fjliving/SmartSleeve/images/DSC02135.JPG

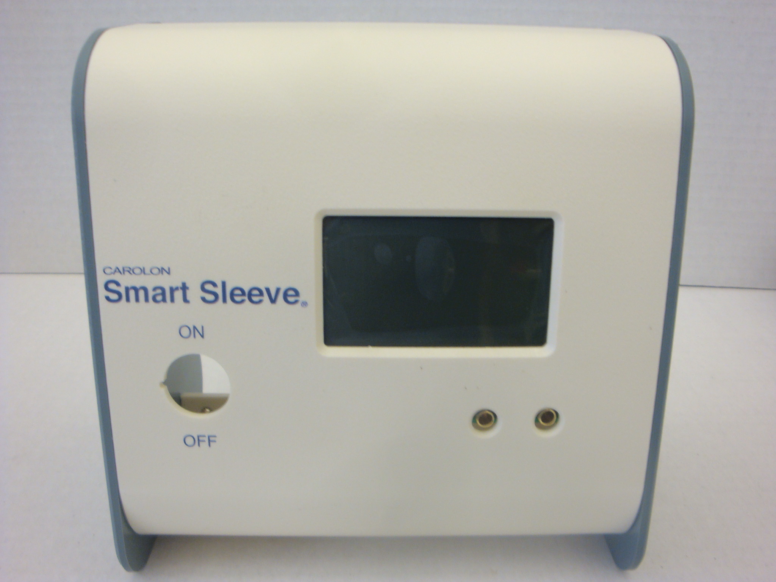
images/DSC02135.JPG
