fjliving/SmartSleeve/images/DSC02167.JPG

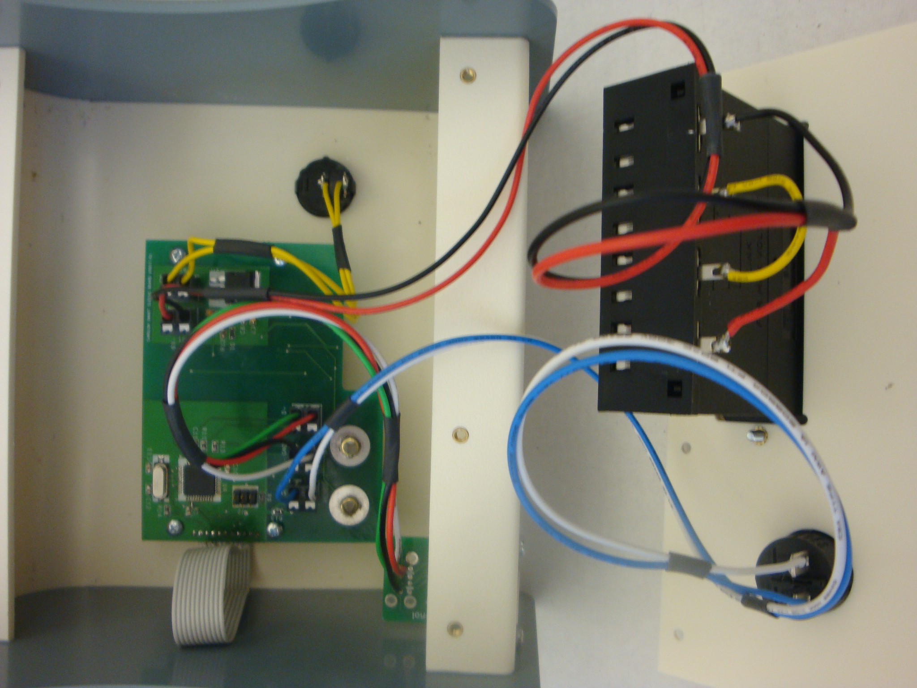
images/DSC02167.JPG
