fjliving/SmartSleeve/cad/6941A002 Smart Reader/GPB527C202Bx.PDF

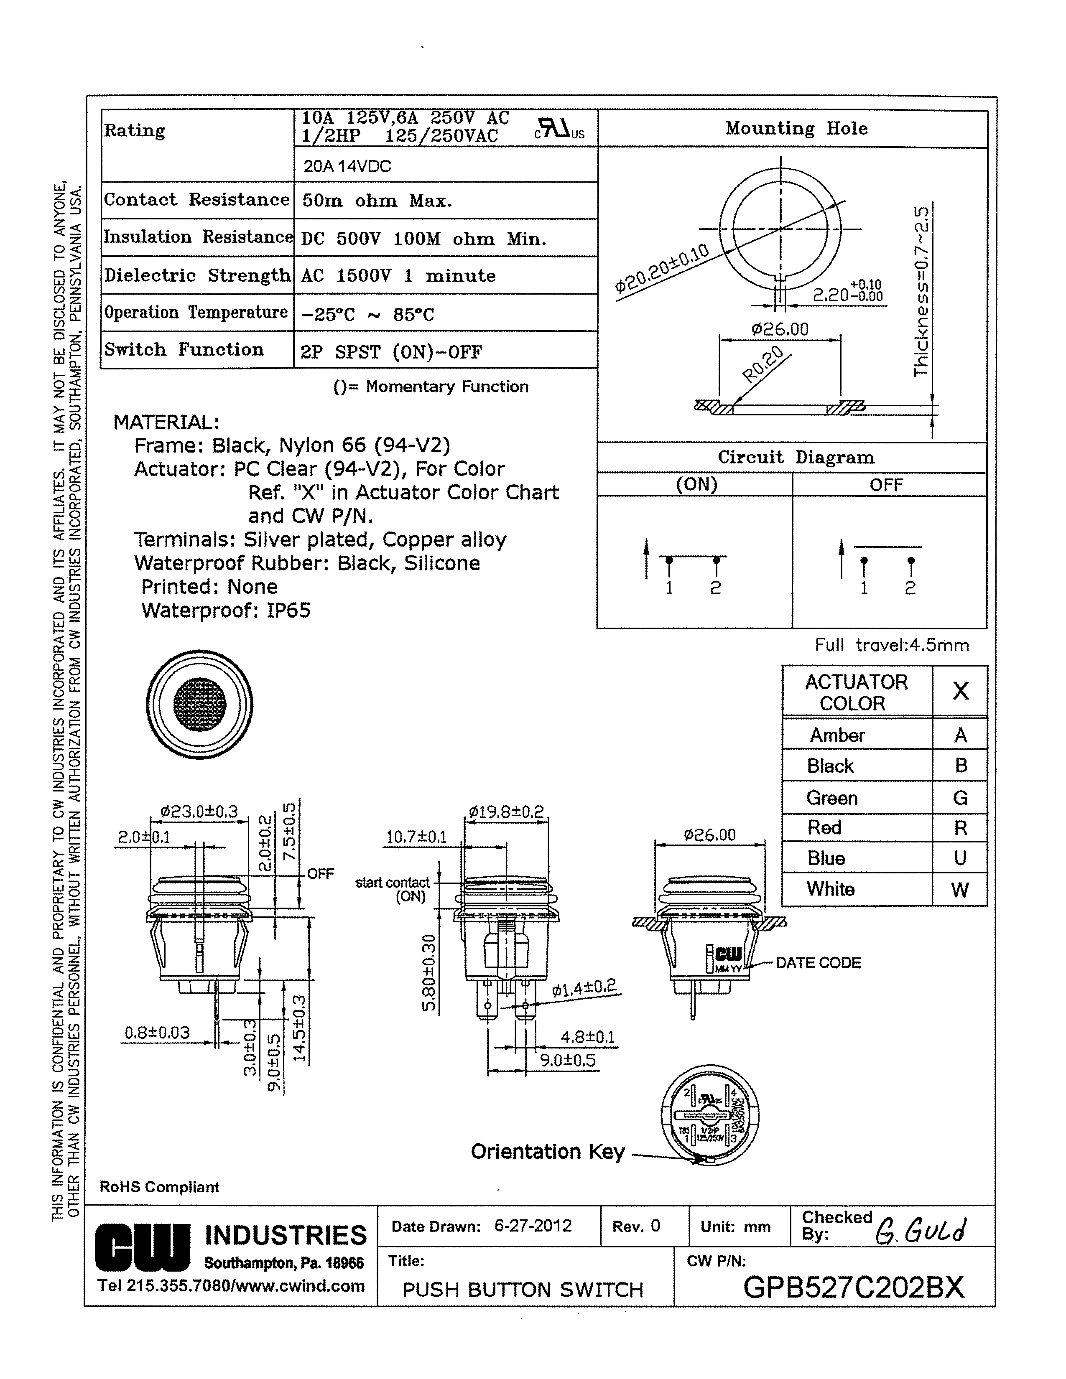
[picture p3: page 1]
