fjliving/SmartSleeve/images/DSC02120.JPG

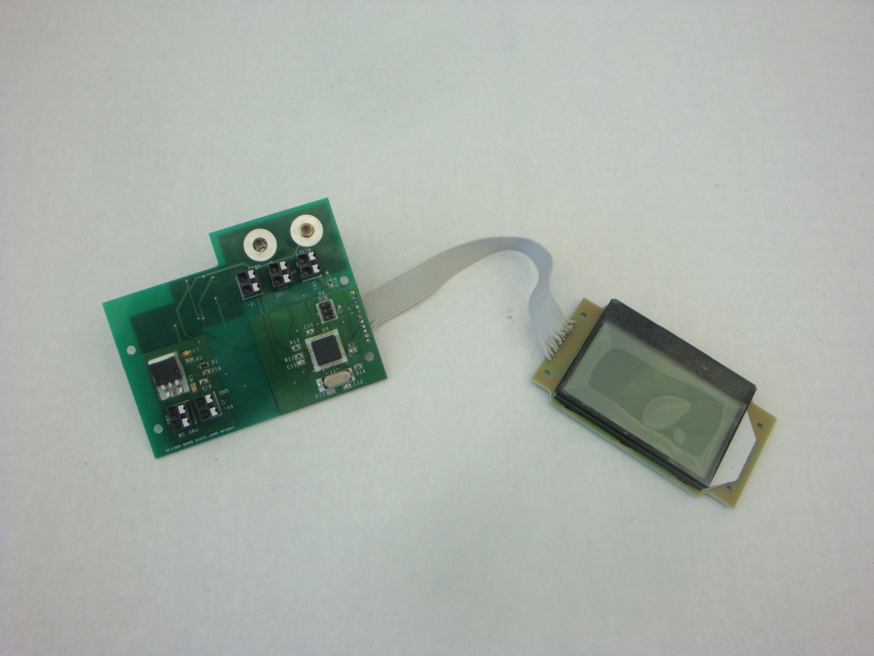
images/DSC02120.JPG
