fjliving/SmartSleeve/images/DSC02123.JPG

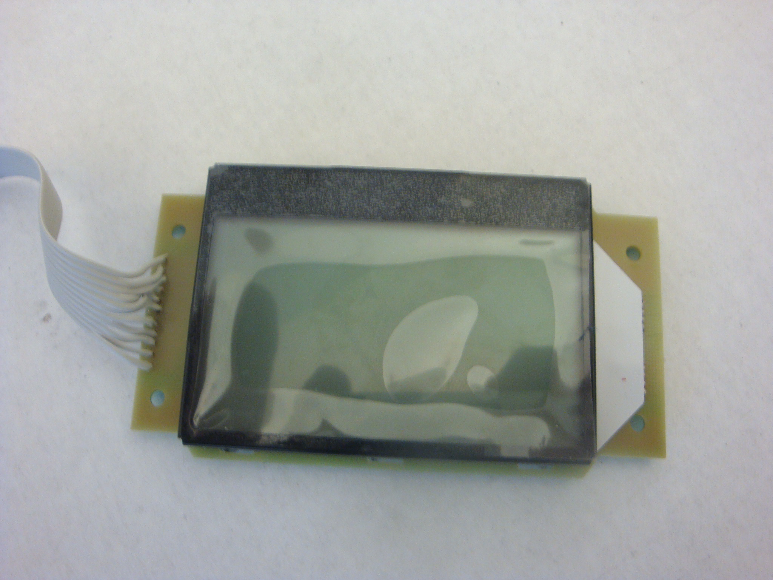
images/DSC02123.JPG
