fjliving/SmartSleeve/images/DSC02127.JPG

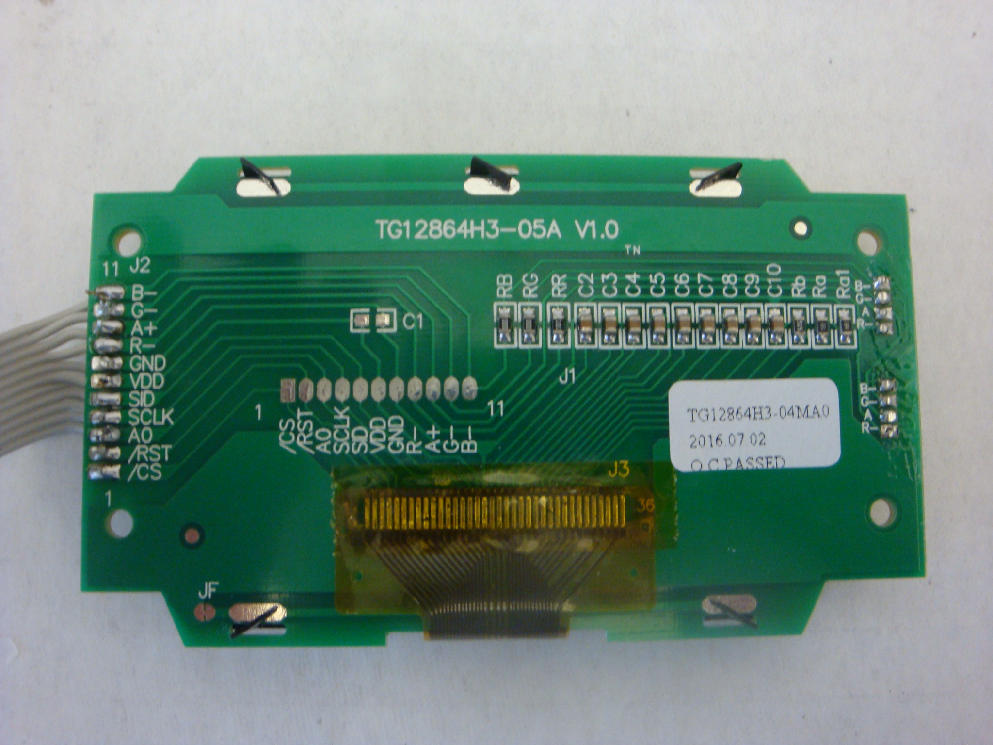
images/DSC02127.JPG
