fjliving/SmartSleeve/images/DSC02134.JPG

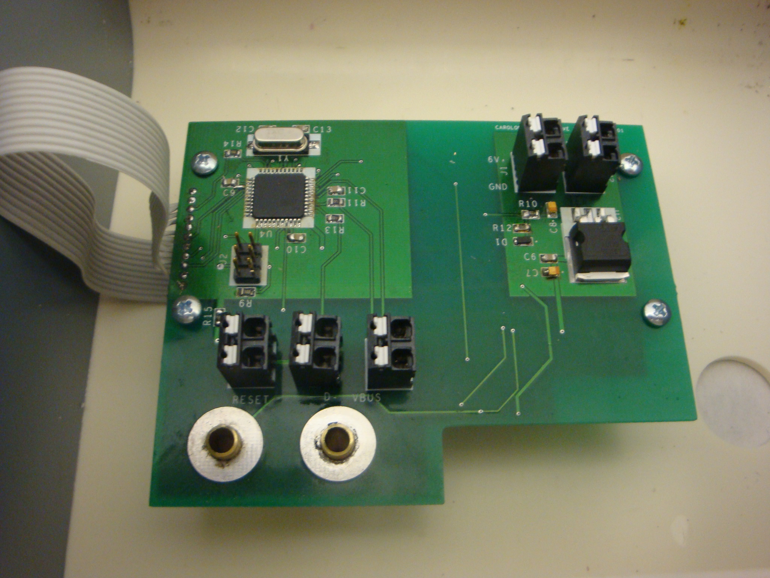
images/DSC02134.JPG
