fjliving/SmartSleeve/images/DSC02145.JPG

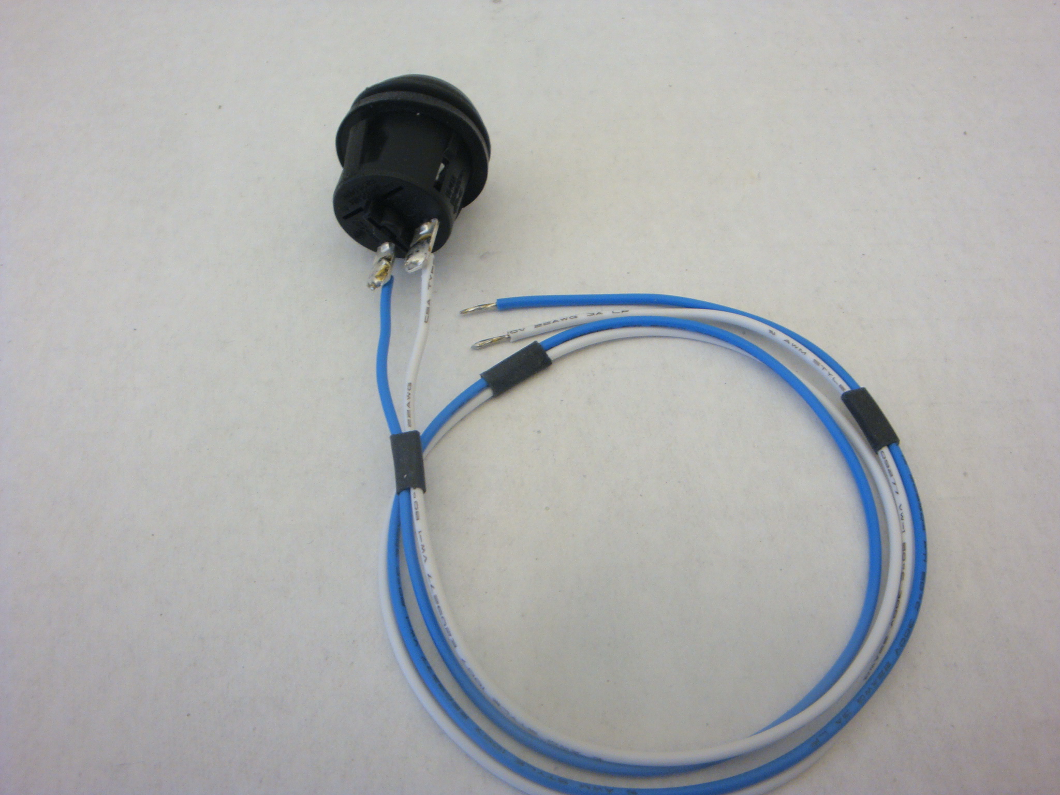
images/DSC02145.JPG
