fjliving/SmartSleeve/images/DSC02146.JPG

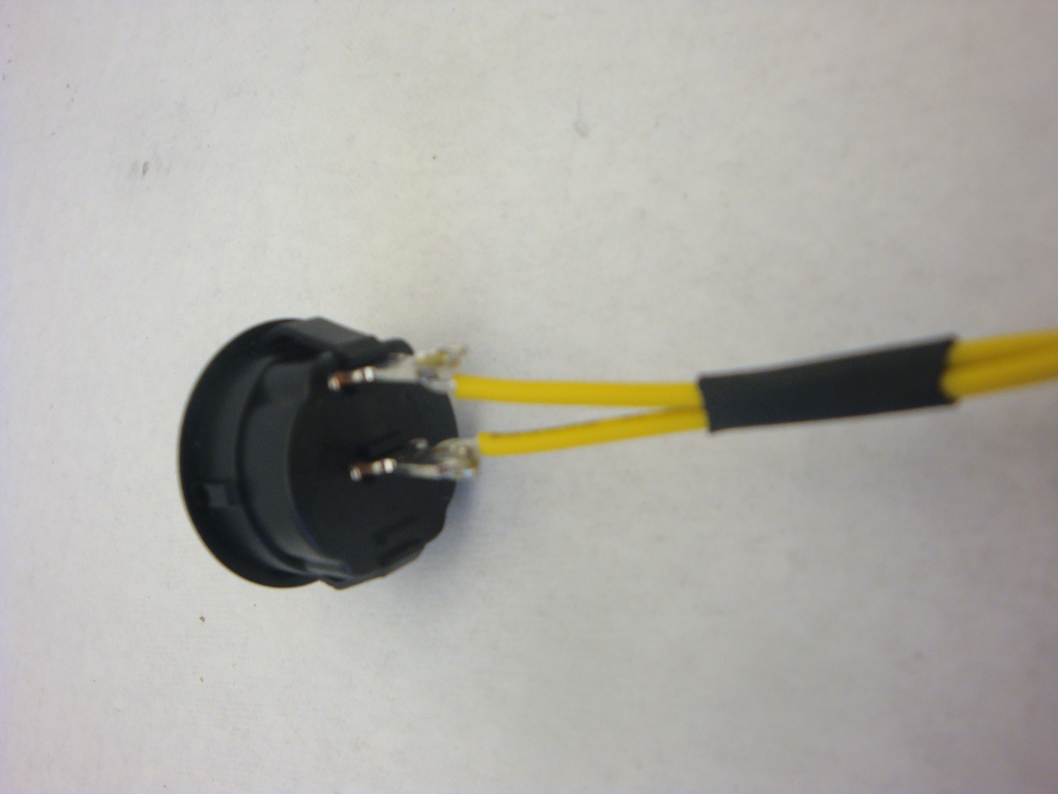
images/DSC02146.JPG
