fjliving/SmartSleeve/images/DSC02156.JPG

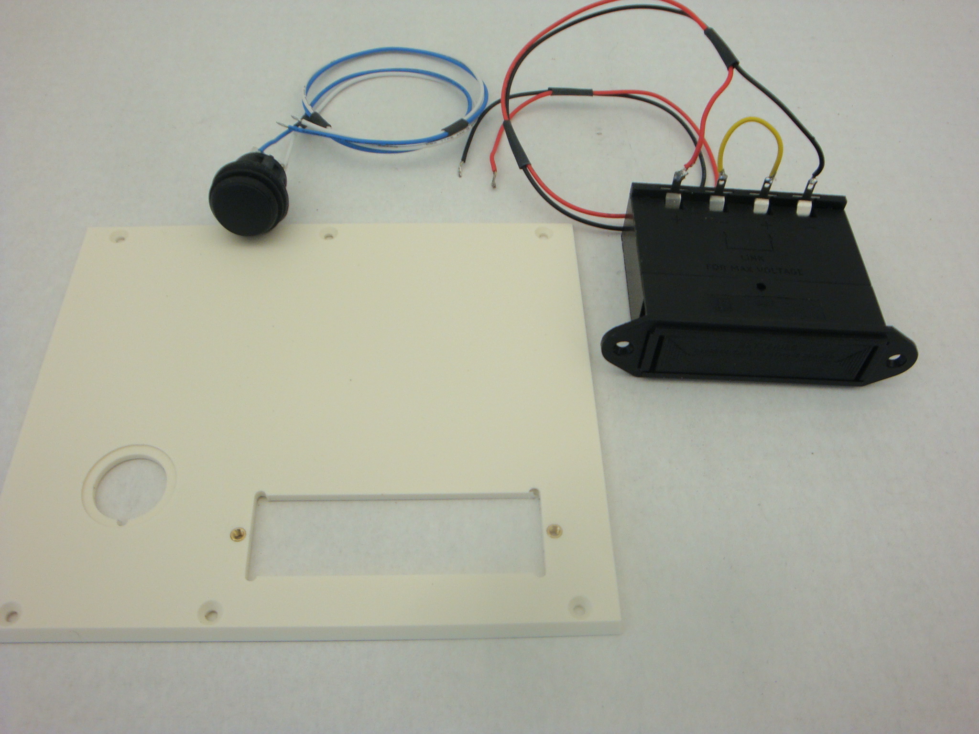
images/DSC02156.JPG
