fjliving/SmartSleeve/images/DSC02157.JPG

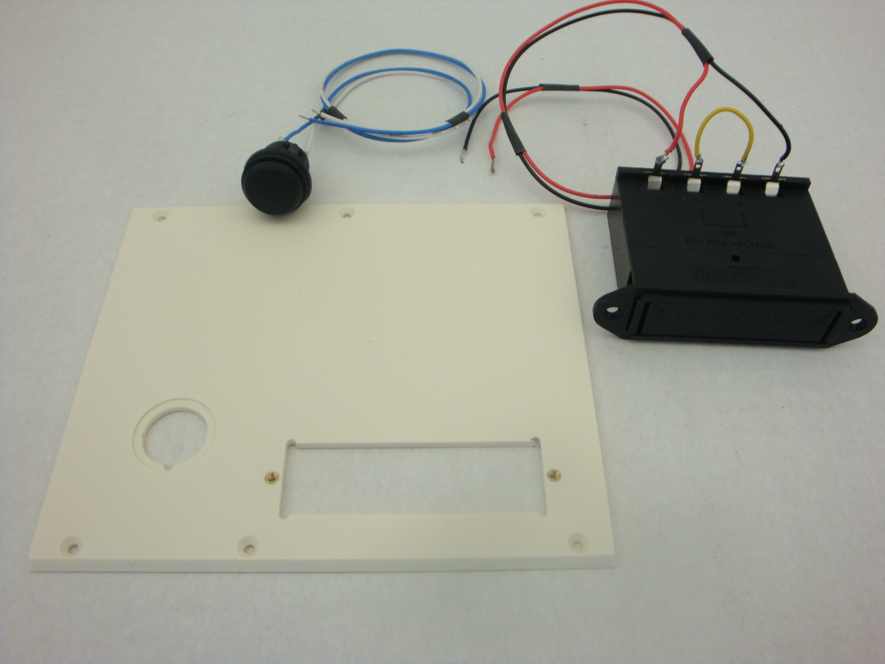
images/DSC02157.JPG
