fjliving/SmartSleeve/images/DSC02166.JPG

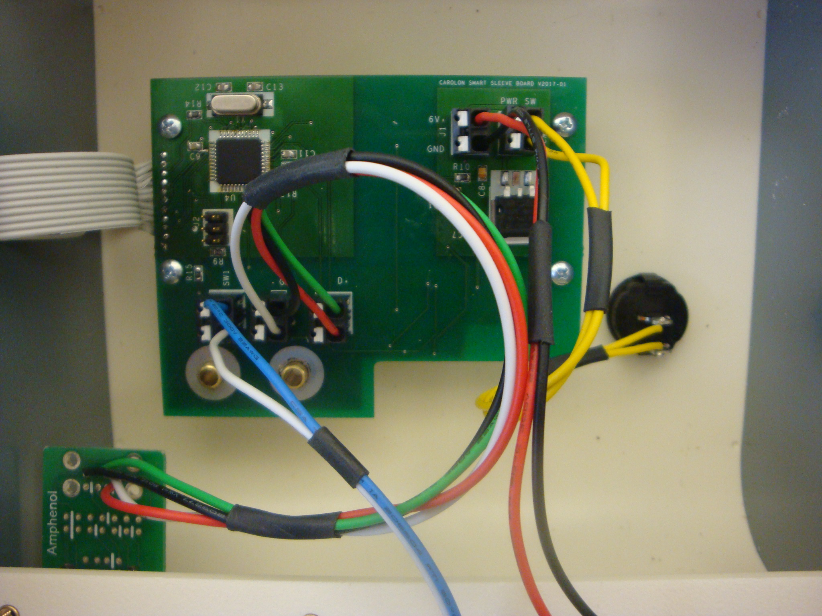
images/DSC02166.JPG
