fjliving/SmartSleeve/images/DSC02176.JPG

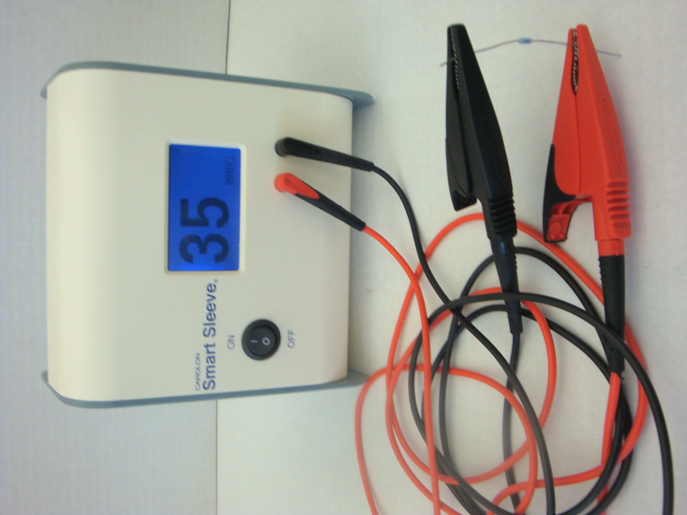
images/DSC02176.JPG
