fjliving/SmartSleeve/images/DSC02177.JPG

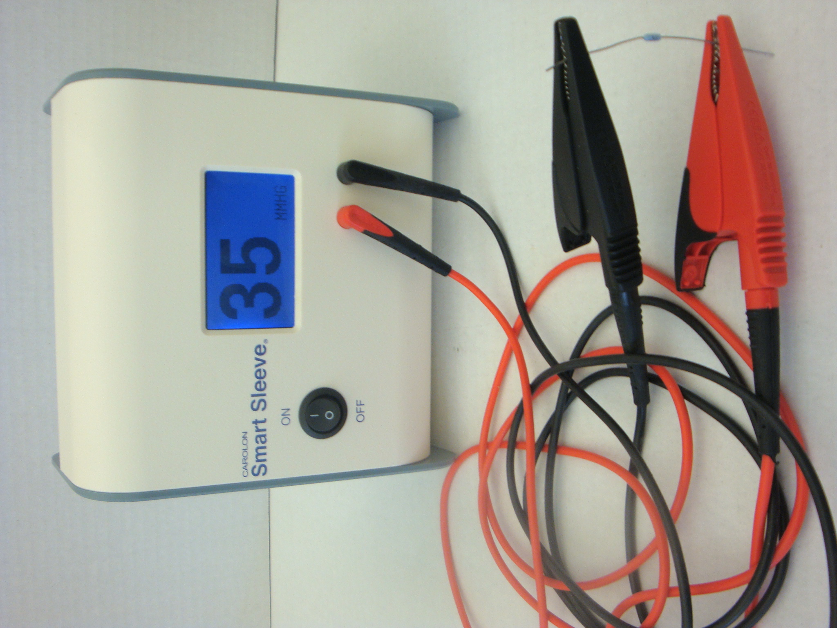
images/DSC02177.JPG
