fjliving/SmartSleeve/images/unnamed (1).jpg

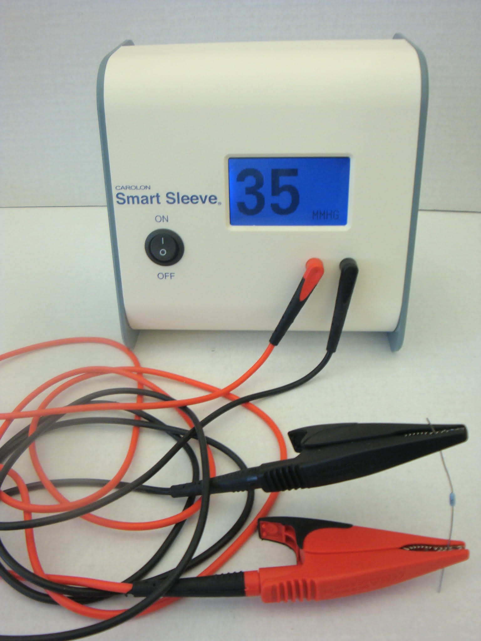
images/unnamed (1).jpg
