fjliving/SmartSleeve/images/unnamed (2).jpg

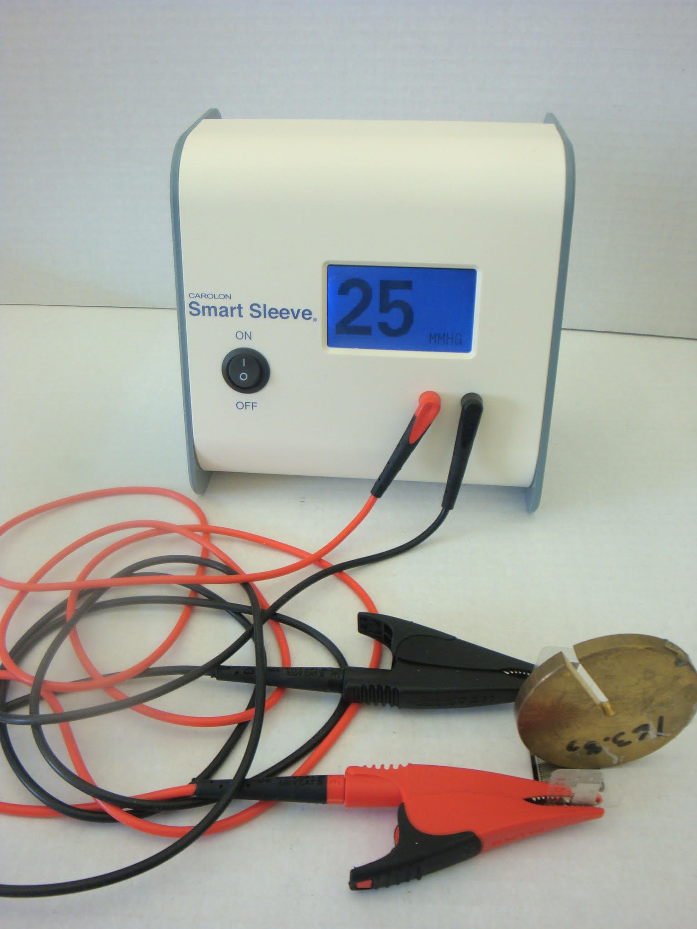
images/unnamed (2).jpg
