fjliving/SmartSleeve/images/unnamed (3).jpg

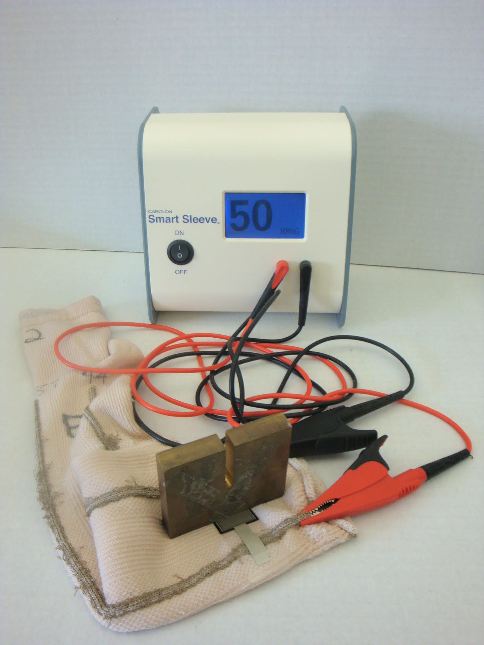
images/unnamed (3).jpg
