fjliving/SmartSleeve/images/unnamed.jpg

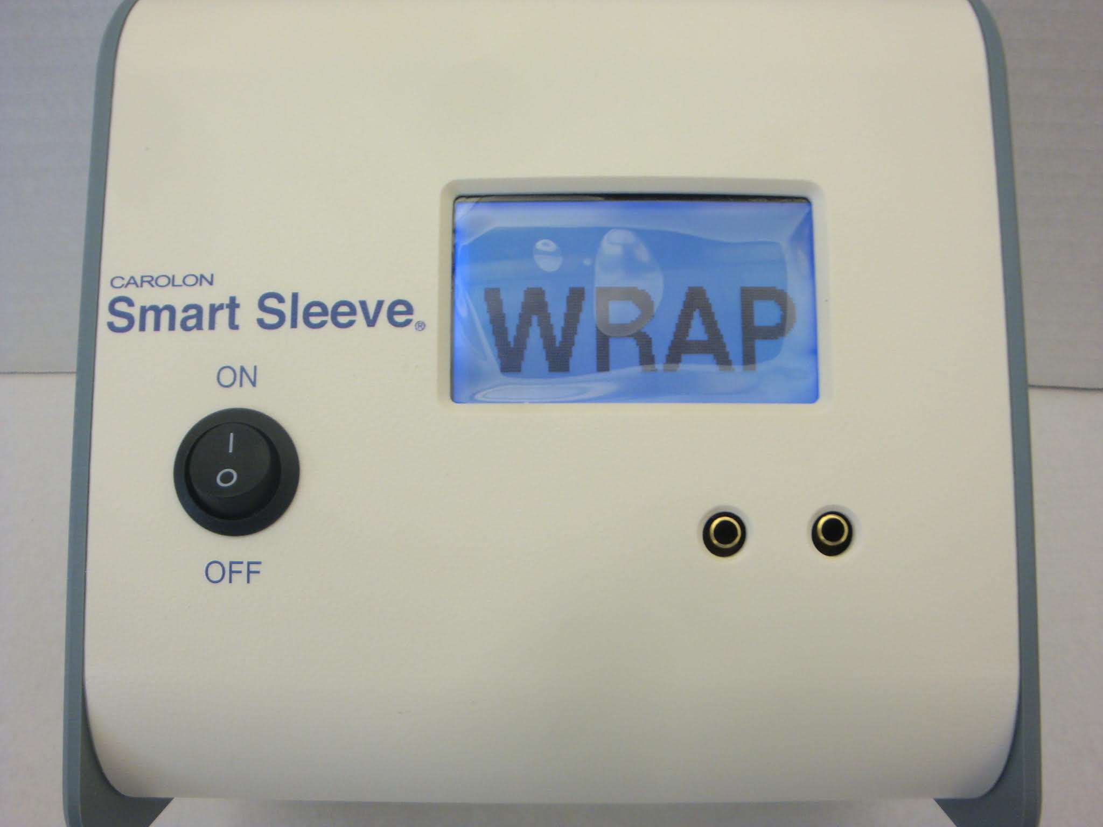
images/unnamed.jpg
