fjliving/SmartSleeve/schematic/SmartSleeveBOM.xlsx

Component | Supplier | Part Number | Item | Footprint | Qnt | Unit Price | Price
ELECTRICAL
U5 | DigiKey | 3M9337-ND | Header 2mm (40 pins) | N/A | 1 | 2.3 | 2.3
J8,J9 | DigiKey | 36-575-8-ND | JACK NON-INSULATED .350" | 129-0701-202 | 2 | 0.99 | 1.98
U5 | AdaFruit | 250 | Graphic ST7565 Positive LCD (https://www.adafruit.com/products/250) | ST7565 | 1 | 16.6 | 16.6
J1 | DigiKey | 708-1399-ND | HOLDER BATTERY 4 CELL AA | N/A | 1 | 20.72 | 20.72
SW2 | DigiKey | EG4777-ND | Rocker Switch SPST | N/A | 1 | 0.93 | 0.93
J10, J11 | DigiKey | MUSBAA11M0-ND | USB Connector | N/A | 1 | 17.35 | 17.35
J1, SW2, J10, J11, SW1 | DigiKey | 277-11636-1-ND | 2 Position Wire to Board Terminal Block | DIP500P550X533-4N | 5 | 1.86 | 9.3
R3,R8 | DigiKey | A110542CT-ND (http://www.digikey.com/product-detail/en/te-connectivity-passive-product/1-2176092-7/A110542CT-ND/4034897) | RES SMD 976 OHM 0.1% 1/4W 0805 | RESC2013X140N | 2 | 0.61 | 1.22
R4,R5,R7 | DigiKey | YAG1988CT-ND (http://www.digikey.com/product-detail/en/yageo/RT0805BRD078K2L/YAG1988CT-ND/5139436) | RES SMD 8.2K OHM 0.1% 1/8W 0805 | RESC2013X140N | 3 | 0.35 | 1.05
R1 | DigiKey | P100KDACT-ND (http://www.digikey.com/product-detail/en/panasonic-electronic-components/ERA-6AEB104V/P100KDACT-ND/1465995) | RES SMD 100K OHM 0.1% 1/8W 0805 | RESC2013X140N | 1 | 0.39 | 0.39
R6 | DigiKey | YAG1766CT-ND (http://www.digikey.com/product-detail/en/yageo/RT0805BRD07113KL/YAG1766CT-ND/5139214) | RES SMD 113K OHM 0.1% 1/8W 0805 | RESC2013X140N | 1 | 0.35 | 0.35
R12 | DigiKey | 311-7.15KCRCT-ND (http://www.digikey.com/product-detail/en/yageo/RC0805FR-077K15L/311-7.15KCRCT-ND/731057) | RES SMD 7.15K OHM 1% 1/8W 0805 | RESC2013X140N | 1 | 0.1 | 0.1
U2 | DigiKey | 497-1224-1-ND (http://www.digikey.com/product-detail/en/stmicroelectronics/LD1086D2T33TR/497-1224-1-ND/586224) | LD1086 IC REG LDO 3.3V 1.5A D2PAK | TO254P1394X457-4N | 1 | 0.96 | 0.96
R2,R14 | DigiKey | 311-100CRCT-ND (http://www.digikey.com/product-detail/en/yageo/RC0805FR-07100RL/311-100CRCT-ND/730490) | RES SMD 100 OHM 1% 1/8W 0805 | RESC2013X140N | 2 | 0.1 | 0.2
R9,R10 | DigiKey | 311-10KARCT-ND (http://www.digikey.com/product-detail/en/yageo/RC0805JR-0710KL/311-10KARCT-ND/731188) | RES SMD 10K OHM 5% 1/8W 0805 | RESC2013X140N | 2 | 0.1 | 0.2
R11,R13 | DigiKey | RMCF0805JT22R0CT-ND (http://www.digikey.com/product-detail/en/stackpole-electronics-inc/RMCF0805JT22R0/RMCF0805JT22R0CT-ND/1942533) | RES SMD 22 OHM 5% 1/8W 0805 | RESC2013X140N | 2 | 0.1 | 0.2
R15 | DigiKey | 311-0.0ARCT-ND (http://www.digikey.com/product-detail/en/yageo/RC0805JR-070RL/311-0.0ARCT-ND/731163) | RES SMD 0.0 OHM JUMPER 1/8W 0805 | RESC2013X140N | 1 | 0.1 | 0.1
U1 | DigiKey | 296-15953-1-ND (http://www.digikey.com/product-detail/en/texas-instruments/INA327EA-250/296-15953-1-ND/606779) | IC OPAMP INSTR 1KHZ RRO 10VSSOP | SOP50P440X140-10N | 1 | 6.21 | 6.21
D1 | DigiKey | 641-1056-1-ND (http://www.digikey.com/product-detail/en/comchip-technology/CZRF52C3V3/641-1056-1-ND/1121178) | DIODE ZENER 3.3V 200MW 1005 | DIOC2512X140N | 1 | 0.54 | 0.54
C1,C7,C8 | DigiKey | 478-3281-1-ND (http://www.digikey.com/product-detail/en/avx-corporation/TAJP106M010RNJ/478-3281-1-ND/930073) | CAP TANT 10UF 10V 20% 0805 | CAPCP2013X140N | 3 | 1.01 | 3.03
C2,C4,C6,C9,C10,C11 | DigiKey | 478-1395-1-ND (http://www.digikey.com/product-detail/en/avx-corporation/08055C104KAT2A/478-1395-1-ND/564427) | CAP CER 0.1UF 50V X7R 0805 | CAPC2013X140N | 6 | 0.1 | 0.6
C3 | DigiKey | 311-1365-1-ND (http://www.digikey.com/product-detail/en/yageo/CC0805KKX7R7BB105/311-1365-1-ND/2103149) | CAP CER 1UF 16V X7R 0805 | CAPC2013X140N | 1 | 0.1 | 0.1
C12,C13 | DigiKey | 276-1107-1-ND (http://www.digikey.com/product-detail/en/samsung-electro-mechanics-america-inc/CL21C180JBANNNC/1276-1107-1-ND/3889193) | CAP CER 18PF 50V NP0 0805 | CAPC2013X140N | 2 | 0.1 | 0.2
C5 | DigiKey | 399-1147-1-ND (http://www.digikey.com/product-detail/en/kemet/C0805C102K5RACTU/399-1147-1-ND/411422) | CAP CER 1000PF 50V X7R 0805 | CAPC2013X140N | 1 | 0.1 | 0.1
U4 | DigiKey | ATMEGA32U4-AURCT-ND (http://www.digikey.com/product-detail/en/microchip-technology/ATMEGA32U4-AUR/ATMEGA32U4-AURCT-ND/3440960) | IC MCU 8BIT 32KB FLASH 44TQFP | QFP80P1200X1200X120-45N | 1 | 4.2 | 4.2
Y1 | DigiKey | 887-1274-1-ND (http://www.digikey.com/product-detail/en/txc-corporation/9C-16.000MEEJ-T/887-1274-1-ND/2207856) | CRYSTAL 16.0000MHZ 18PF SMD | CRYSTAL1190X300N | 1 | 0.59 | 0.59
J2 | DigiKey | 609-3234-ND | CONN HEADER 6POS .100 STR 15AU | DIP254P254X533-6N | 1 | 0.31 | 0.31
SW1 | DigiKey | CW153-ND | SWITCH PUSH SPST-NO 10A 125V | N/A | 1 | 2.41 | 2.41
J4,J5,J6,J7 | N/A | N/A | MNT HOLES | HOLE125 | 1 | 0 | 0
U6 | DigiKey | LT1790BCS6-3#TRMPBFCT-ND (http://www.digikey.com/product-detail/en/linear-technology/LT1790BCS6-3-TRMPBF/LT1790BCS6-3-TRMPBFCT-ND/889008) | IC VREF SERIES 3V SOT23-6 | SOT95P280X112-6N | 1 | 3.18 | 3.18
MECHANICAL
 | McMasterCarr | 90295A340 | Washer Number 4 Screw Size, 0.112" ID, 0.206" OD (100 QTY) | 4 per enclosure | 1 | 5.17 | 5.17
 | McMasterCarr | 90272A077 | 2-56 Thread Size, 1/4" Long (100 QTY) | 2 per enclosure | 1 | 2.64 | 2.64
 | McMasterCarr | 90272A108 | 4-40 Thread Size, 3/8" Long (100 QTY) | 8 per enclosure | 1 | 1.6 | 1.6
 | Toolless |  | Production Enclosure (25x $50.42, 50x 42.01, 100x $35.01) |  | 1 | 50.42 | 50.42
 | Toolless |  | Digital Printing (25x $9.96, 50x $5.70, 100x $3.80) |  | 1 | 9.96 | 9.96
 |  |  | TOTAL |  | 54 |  | 165.21
 | Obmitted from Design FJL 03/07/2017
