fjliving/SmartSleeve/cad/6941A001 Smart Reader 2016-12-15/6941 500 Smart Reader.SLDASM

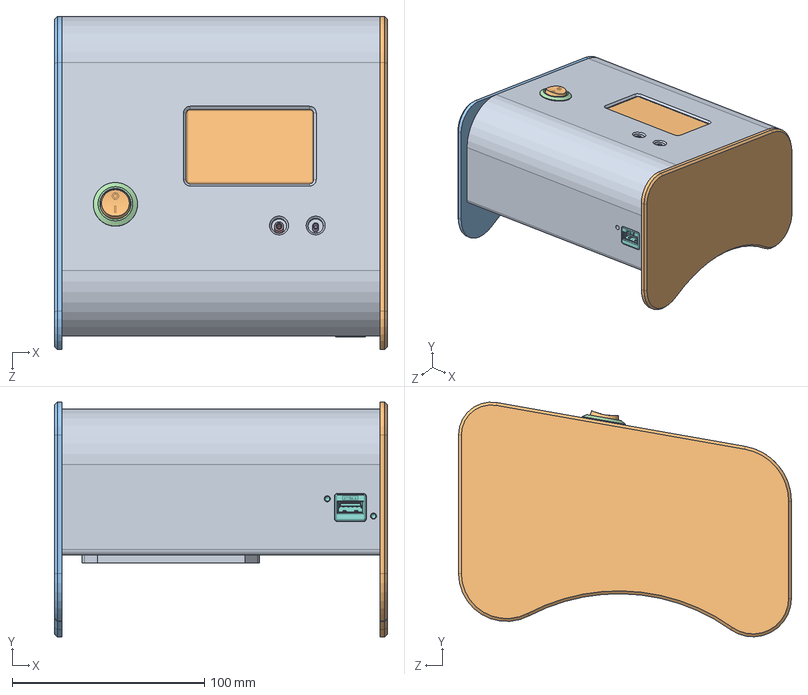
[picture p19: CAD file, 2017-01-30]
cad/6941A001 Smart Reader 2016-12-15/6941 500 Smart Reader.SLDASM
173.1 x 121.9 x 173.0 mm
6941 AA Wrap
6941 AB End Cap
6941 AD Mtg Bar x 2
6941 AE Access Panel
CLPM50H120 x 4
INS440135 x 8
INSM25135 x 4
pcb
lcd_pcb
951140-8622-AR
90295A040_NYLON FLAT WASHER x 4
277-11614-1-ND x 4
MUSBAA11M0
bx0027
RR5-ROCKER I-O
RR5-4.8 TAB Small Hole x 2
RR5 BODY
