fjliving/SmartSleeve/cad/solidworks_2016_org/PCB smartreader_v3.SLDASM

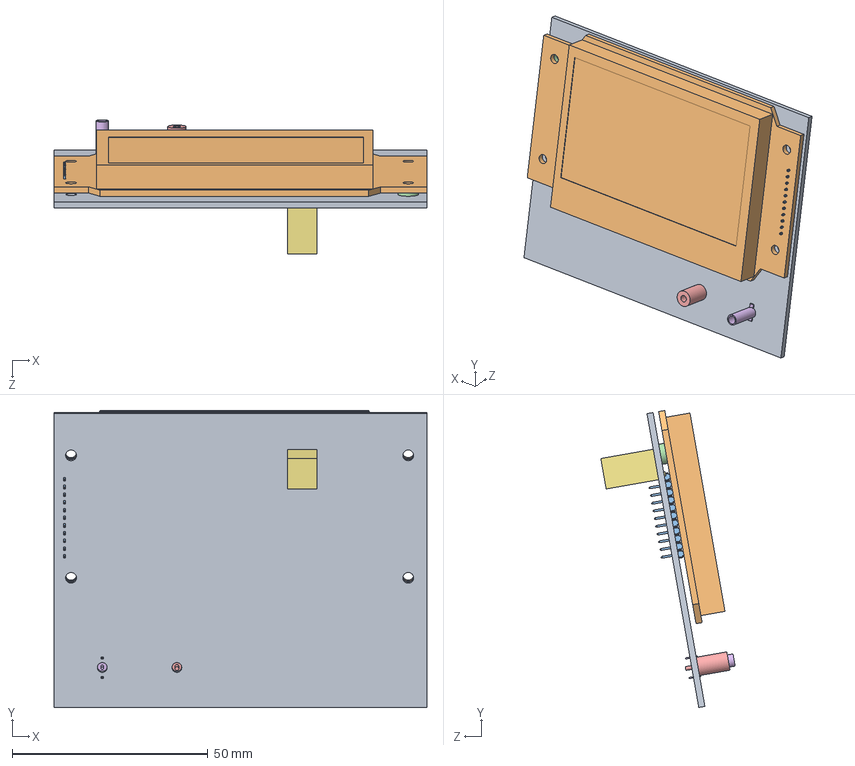
[picture p20: CAD file, 2017-01-30]
cad/solidworks_2016_org/PCB smartreader_v3.SLDASM
95.2 x 75.8 x 34.3 mm
pcb
lcd_pcb
951140-8622-AR
90295A040_NYLON FLAT WASHER
277-11614-1-ND
