fjliving/SmartSleeve/cad/6941A001 Smart Reader 2016-12-15/PCB smartreader_v3.SLDASM

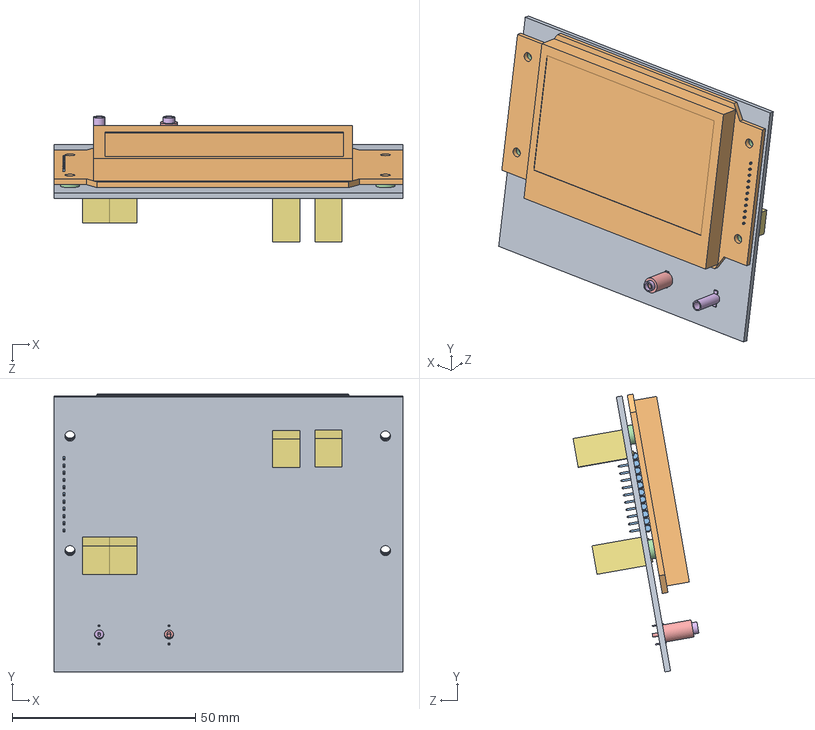
[picture p21: CAD file, 2017-01-30]
cad/6941A001 Smart Reader 2016-12-15/PCB smartreader_v3.SLDASM
95.2 x 75.8 x 34.3 mm
pcb
lcd_pcb
951140-8622-AR
90295A040_NYLON FLAT WASHER x 4
277-11614-1-ND x 4
