fjliving/SmartSleeve/cad/solidworks_2016_org/RR5-4.8 Rocker Switch.SLDASM

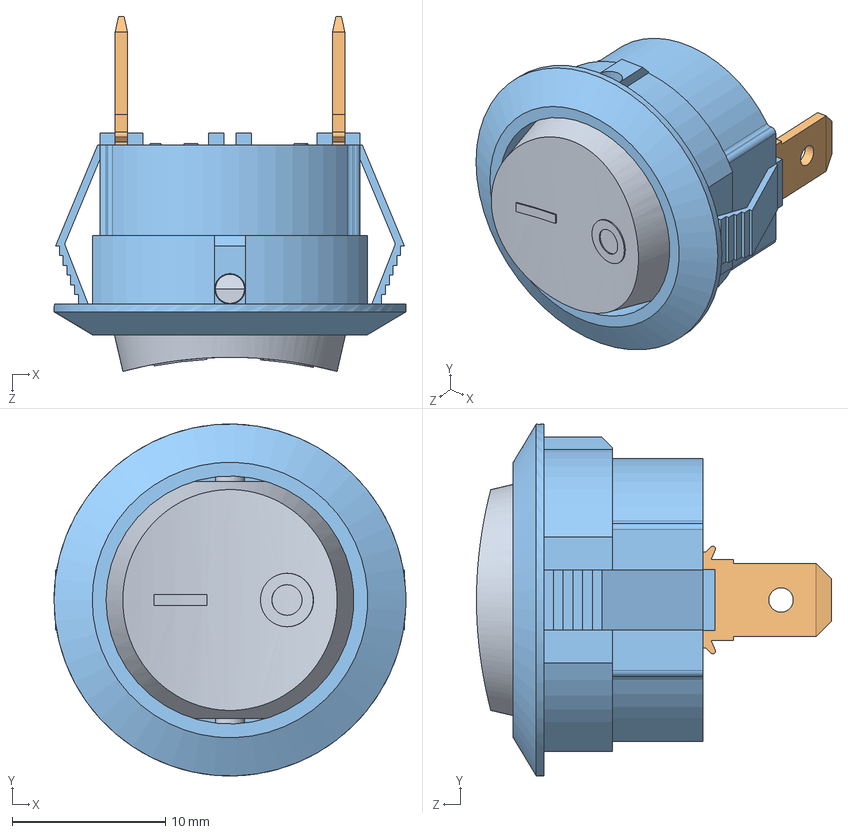
[picture p22: CAD file, 2017-01-10]
cad/solidworks_2016_org/RR5-4.8 Rocker Switch.SLDASM
23.0 x 23.0 x 23.2 mm
RR5-ROCKER I-O
RR5-4.8 TAB Small Hole x 2
RR5 BODY
