fjliving/SmartSleeve/cad/solidworks_2016_org/smartreader_v3.SLDASM

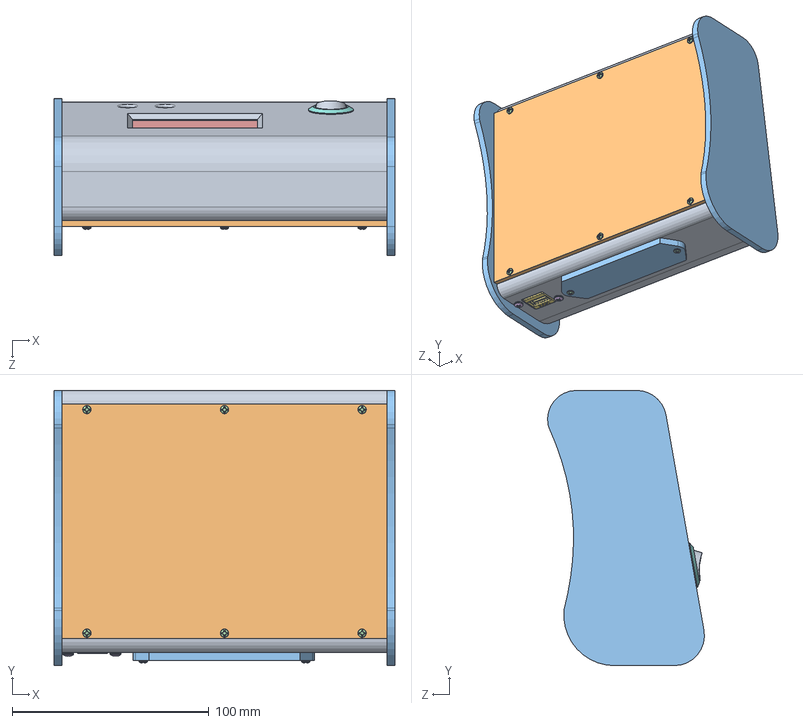
[picture p23: CAD file, 2016-12-14]
cad/solidworks_2016_org/smartreader_v3.SLDASM
173.1 x 139.7 x 79.6 mm
case_front_flange
case_back_flange
case_stand x 2
pcb
lcd_pcb
951140-8622-AR
90295A040_NYLON FLAT WASHER x 4
277-11614-1-ND x 4
bx0027
90272A077_ZINC-PLTD STL PAN HEAD PHILLIPS MACHINE SCREW x 12
92394A111_18-8SS PRESS-FIT EXPANSION INSERT FOR PLASTIC x 8
90272A108_ZINC-PLTD STL PAN HEAD PHILLIPS MACHINE SCREW x 2
MUSBAA11M0
RR5 BODY
RR5-ROCKER I-O
RR5-4.8 TAB Small Hole x 2
