fjliving/SmartSleeve/cad/solidworks_2016_org/RR51xDxx21.SLDASM

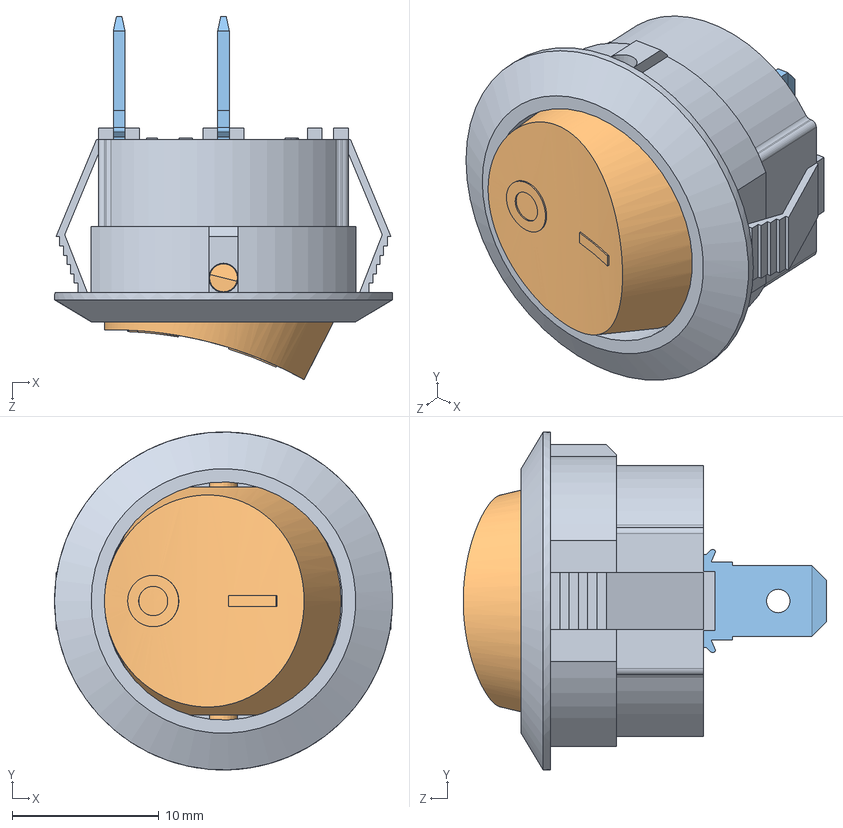
[picture p24: CAD file, 2016-12-14]
cad/solidworks_2016_org/RR51xDxx21.SLDASM
23.0 x 23.0 x 24.7 mm
RR5 BODY
RR5-ROCKER I-O
RR5-4.8 TAB Small Hole x 2
