fjliving/SmartSleeve/cad/solidworks_2016_org/smartreader_lcd_v3.SLDASM

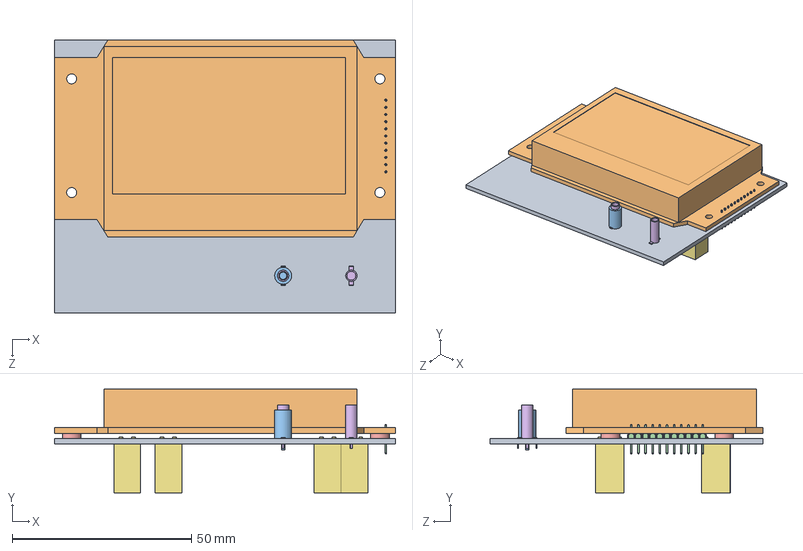
[picture p25: CAD file, 2016-12-14]
cad/solidworks_2016_org/smartreader_lcd_v3.SLDASM
95.2 x 29.0 x 76.2 mm
pcb
lcd_pcb
951140-8622-AR
90295A040_NYLON FLAT WASHER x 4
277-11614-1-ND x 4
