fjliving/SmartSleeve/cad/solidworks_2016_org/M-MUSB-AA11-XX-REVG1.SLDASM

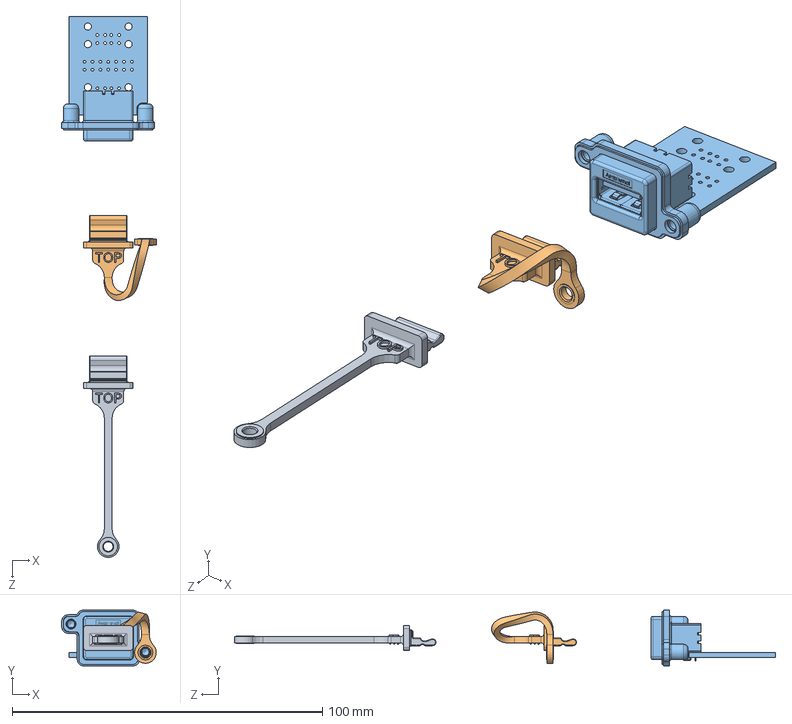
[picture p26: CAD file, 2016-12-14]
cad/solidworks_2016_org/M-MUSB-AA11-XX-REVG1.SLDASM
30.5 x 18.0 x 174.5 mm
MUSB-2A111-0X4 STRAIGHT
MUSB-2A111-0X4-ASSY
MUSB-AA11-35
