fjliving/SmartSleeve/cad/encaps/6941 AB End Cap.DXF

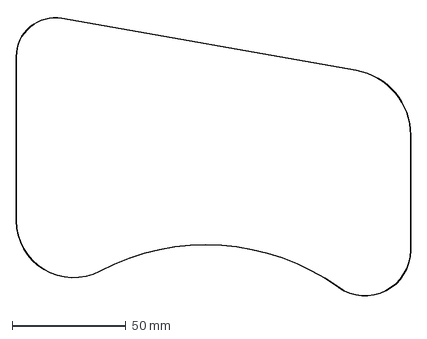
[picture p27: CAD file, 2017-01-10]
cad/encaps/6941 AB End Cap.DXF
173.0 x 123.8 mm
