fjliving/SmartSleeve/cad/6941A001 Smart Reader 2016-12-15/6941 AB End Cap.SLDPRT

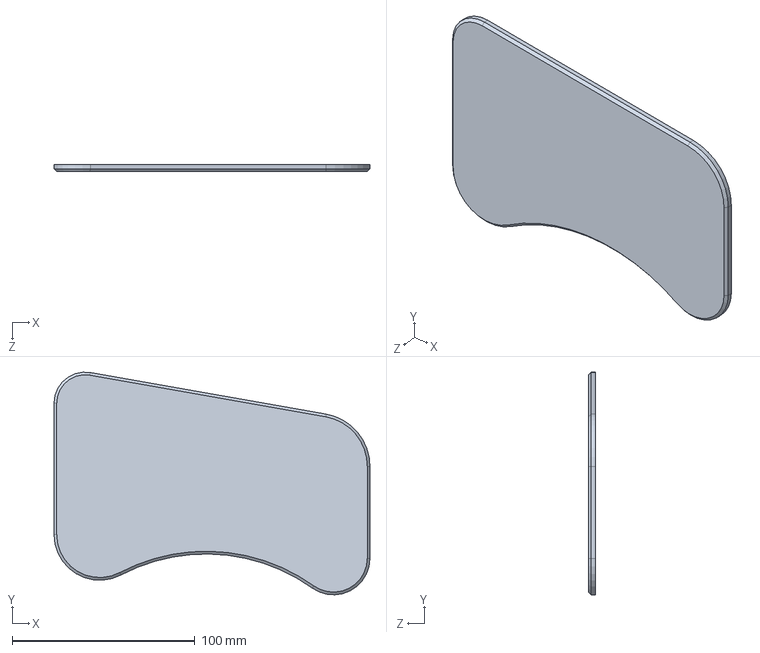
[picture p28: CAD file, 2017-01-30]
cad/6941A001 Smart Reader 2016-12-15/6941 AB End Cap.SLDPRT
173.0 x 121.9 x 4.00 mm
