fjliving/SmartSleeve/cad/solidworks_2016_org/lcd_pcb.SLDPRT

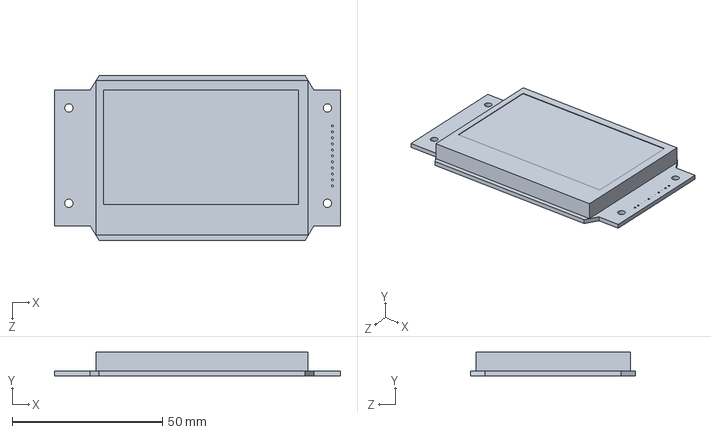
[picture p29: CAD file, 2017-01-30]
cad/solidworks_2016_org/lcd_pcb.SLDPRT
95.2 x 7.84 x 55.0 mm
