fjliving/SmartSleeve/cad/solidworks_2016_org/INSM25135.SLDPRT

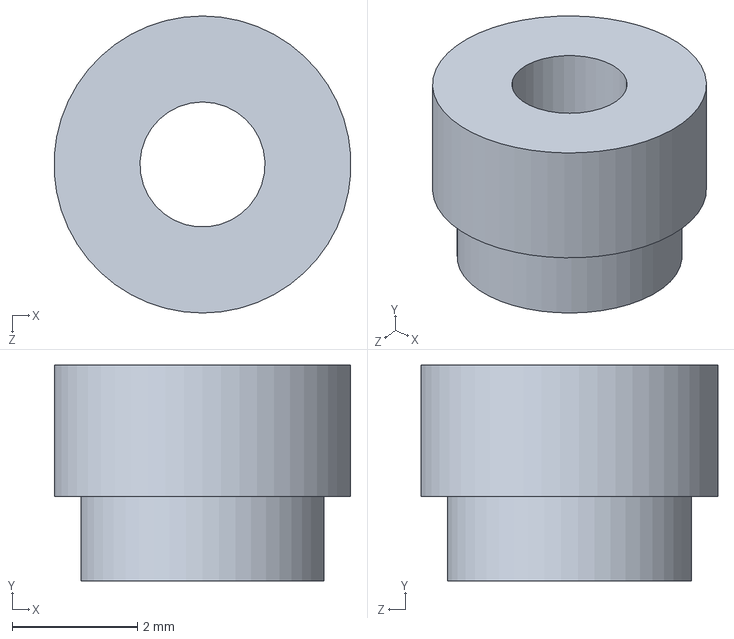
[picture p30: CAD file, 2017-01-10]
cad/solidworks_2016_org/INSM25135.SLDPRT
4.74 x 3.45 x 4.75 mm
