fjliving/SmartSleeve/cad/6941A001 Smart Reader 2016-12-15/CLPM50H120.SLDPRT

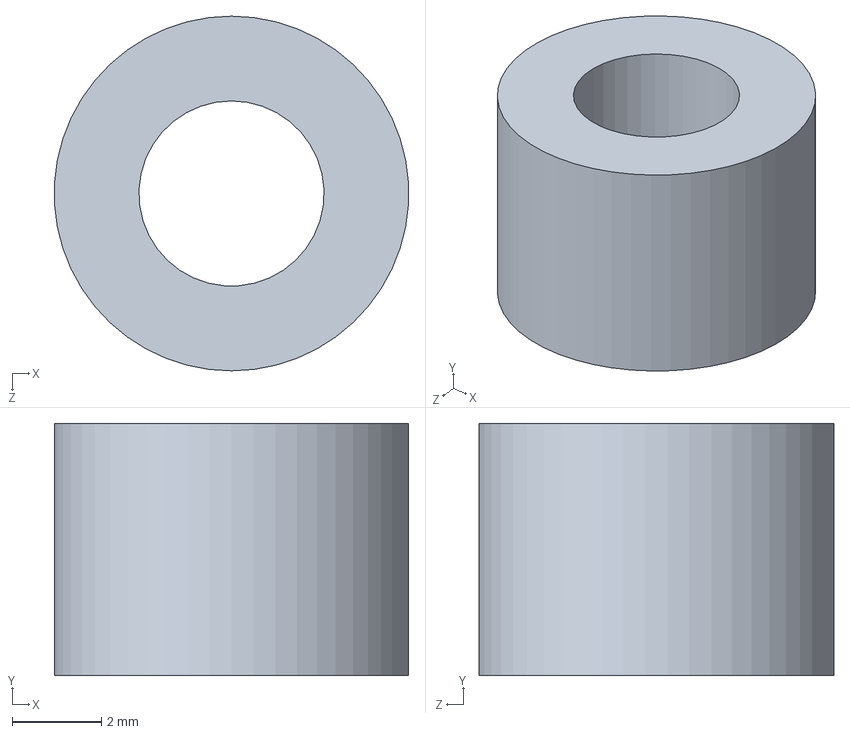
[picture p31: CAD file, 2017-01-30]
cad/6941A001 Smart Reader 2016-12-15/CLPM50H120.SLDPRT
7.93 x 5.65 x 7.95 mm
