fjliving/SmartSleeve/cad/solidworks_2016_org/case_stand.SLDPRT

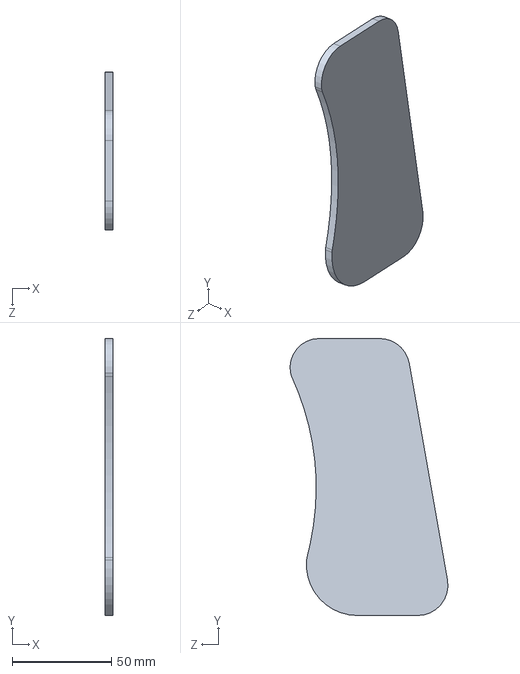
[picture p32: CAD file, 2016-12-14]
cad/solidworks_2016_org/case_stand.SLDPRT
4.00 x 139.7 x 79.6 mm
