fjliving/SmartSleeve/cad/6941A001 Smart Reader 2016-12-15/RR5 BODY.sldprt

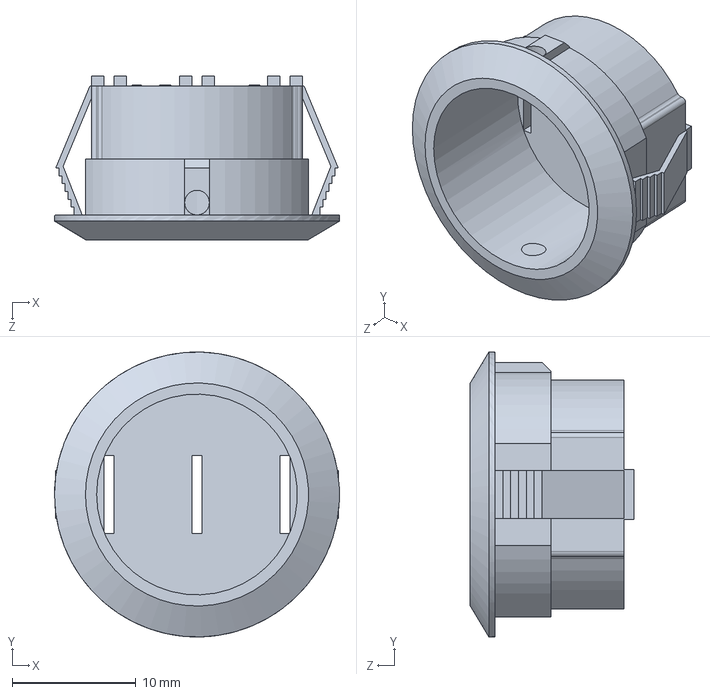
[picture p33: CAD file, 2017-01-10]
cad/6941A001 Smart Reader 2016-12-15/RR5 BODY.sldprt
23.0 x 23.0 x 13.2 mm
