fjliving/SmartSleeve/cad/solidworks_2016_org/case_front_flange.SLDPRT

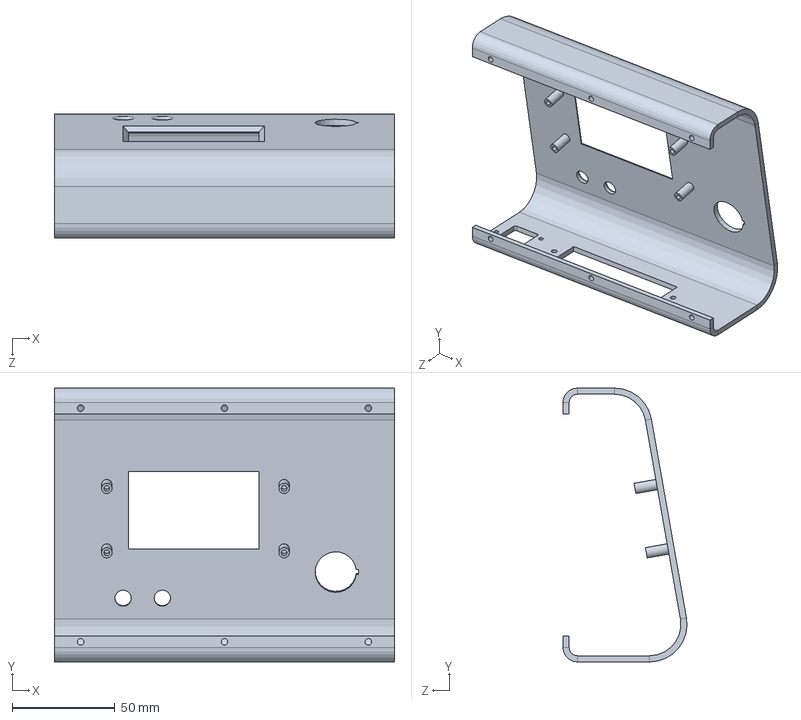
[picture p34: CAD file, 2016-12-14]
cad/solidworks_2016_org/case_front_flange.SLDPRT
165.1 x 133.0 x 60.2 mm
