fjliving/SmartSleeve/cad/6941A001 Smart Reader 2016-12-15/6941 AB End Cap_ORG.SLDPRT

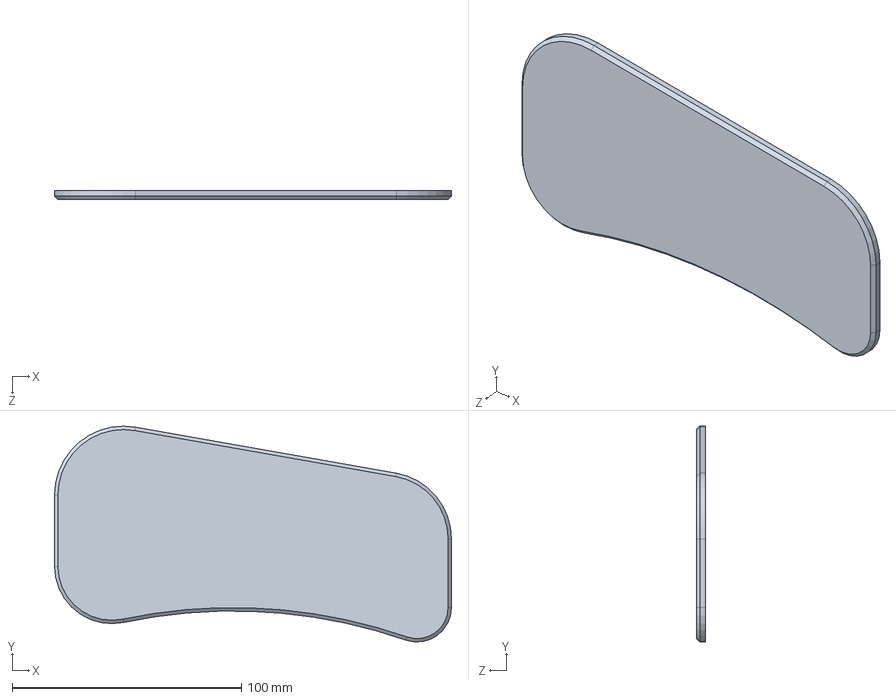
[picture p35: CAD file, 2017-01-10]
cad/6941A001 Smart Reader 2016-12-15/6941 AB End Cap_ORG.SLDPRT
173.0 x 94.0 x 4.00 mm
