fjliving/SmartSleeve/cad/solidworks_2016_org/case_back_flange.SLDPRT

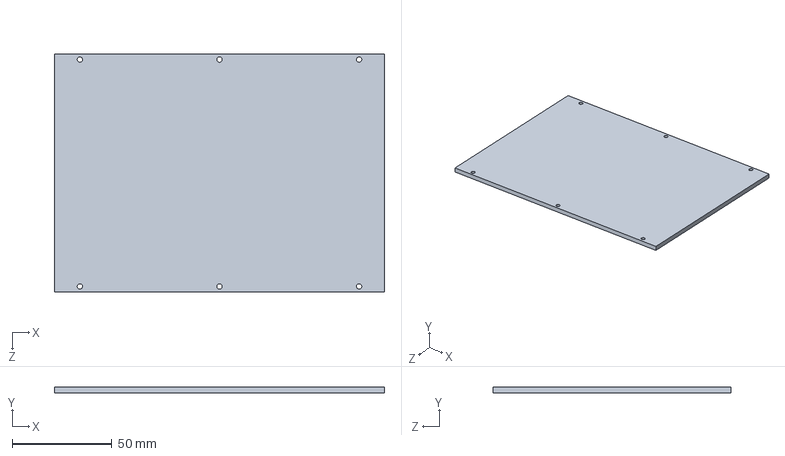
[picture p36: CAD file, 2016-12-14]
cad/solidworks_2016_org/case_back_flange.SLDPRT
165.1 x 3.00 x 119.0 mm
