fjliving/SmartSleeve/cad/6941A001 Smart Reader 2016-12-15/bx0027.sldprt

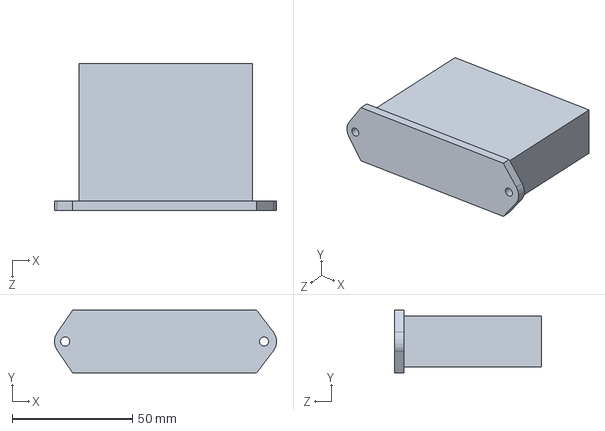
[picture p37: CAD file, 2017-01-10]
cad/6941A001 Smart Reader 2016-12-15/bx0027.sldprt
92.2 x 26.0 x 61.2 mm
