fjliving/SmartSleeve/cad/solidworks_2016_org/RR5-ROCKER I-O.sldprt

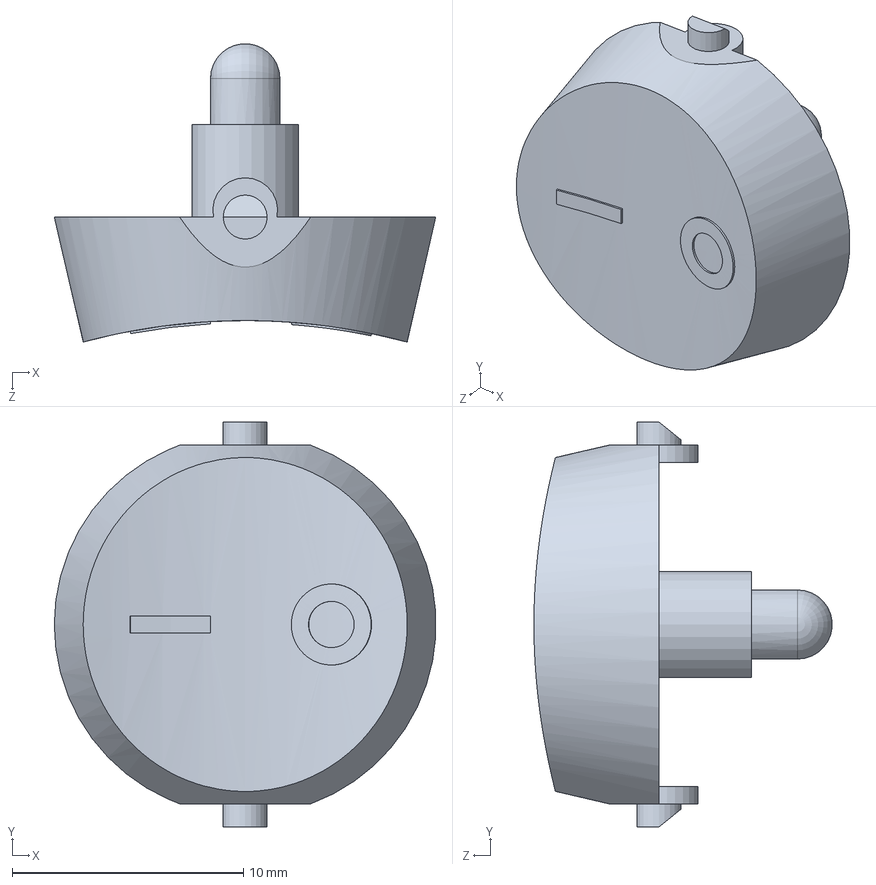
[picture p38: CAD file, 2016-12-14]
cad/solidworks_2016_org/RR5-ROCKER I-O.sldprt
16.5 x 17.5 x 12.9 mm
