fjliving/SmartSleeve/cad/solidworks_2016_org/pcb_test.SLDPRT

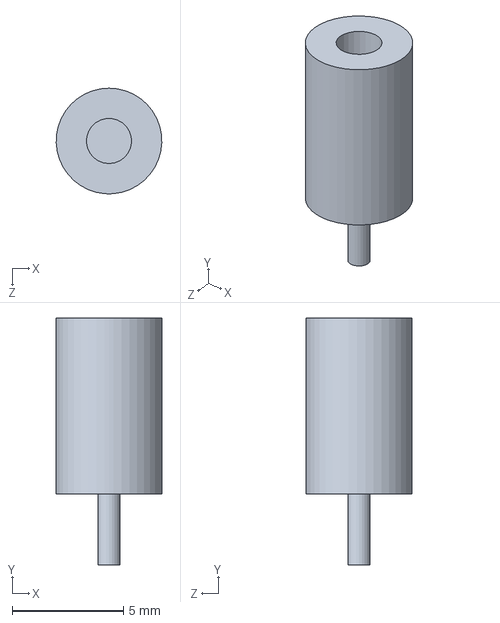
[picture p39: CAD file, 2016-12-14]
cad/solidworks_2016_org/pcb_test.SLDPRT
4.75 x 11.1 x 4.75 mm
