fjliving/SmartSleeve/cad/6941A001 Smart Reader 2016-12-15/6941 AA Wrap.SLDPRT

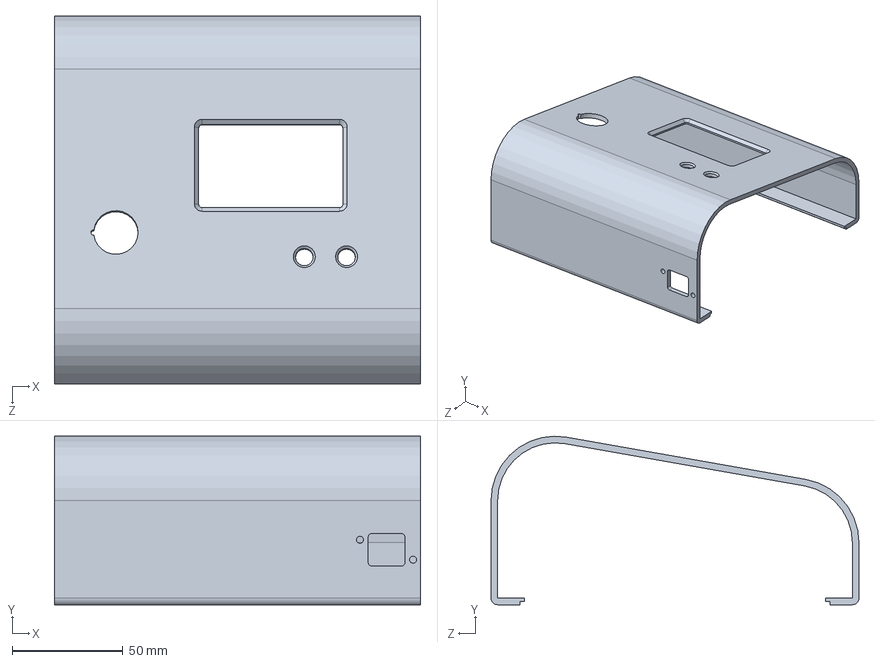
[picture p40: CAD file, 2017-01-10]
cad/6941A001 Smart Reader 2016-12-15/6941 AA Wrap.SLDPRT
165.1 x 76.0 x 166.0 mm
