fjliving/SmartSleeve/cad/solidworks_2016_org/129-0701-202.SLDPRT

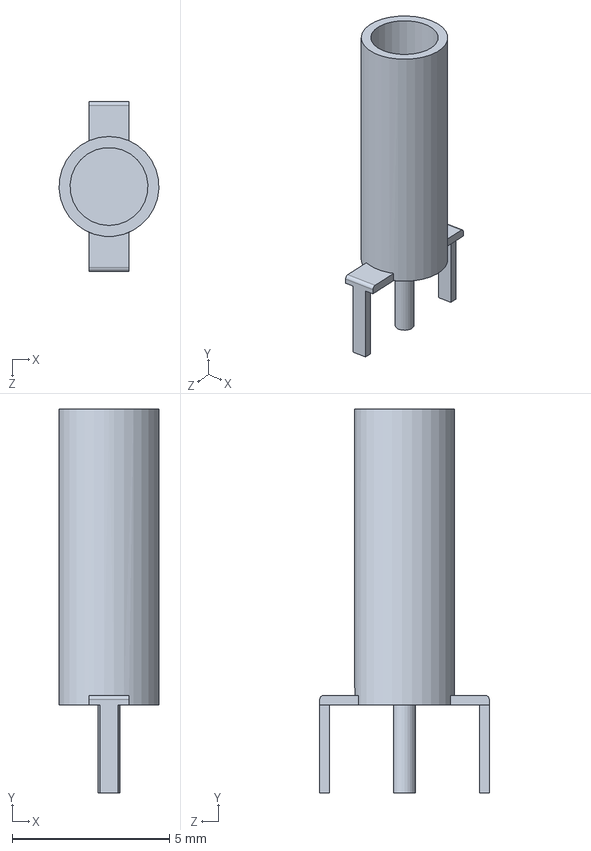
[picture p41: CAD file, 2016-12-14]
cad/solidworks_2016_org/129-0701-202.SLDPRT
3.17 x 12.2 x 5.38 mm
