fjliving/SmartSleeve/cad/6941A001 Smart Reader 2016-12-15/6941 AD Mtg Bar.SLDPRT

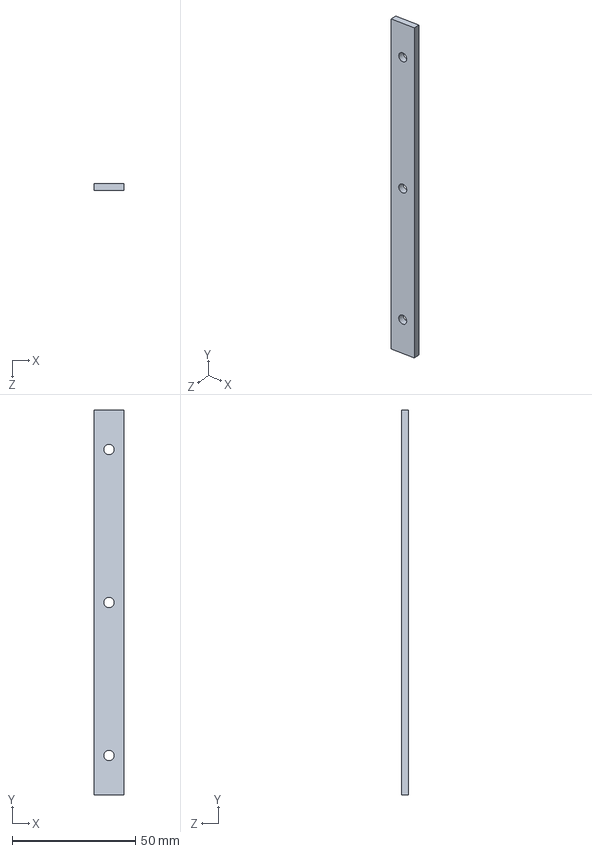
[picture p42: CAD file, 2017-01-10]
cad/6941A001 Smart Reader 2016-12-15/6941 AD Mtg Bar.SLDPRT
12.0 x 156.0 x 3.00 mm
