fjliving/SmartSleeve/cad/solidworks_2016_org/RR5-4.8 TAB Small Hole.sldprt

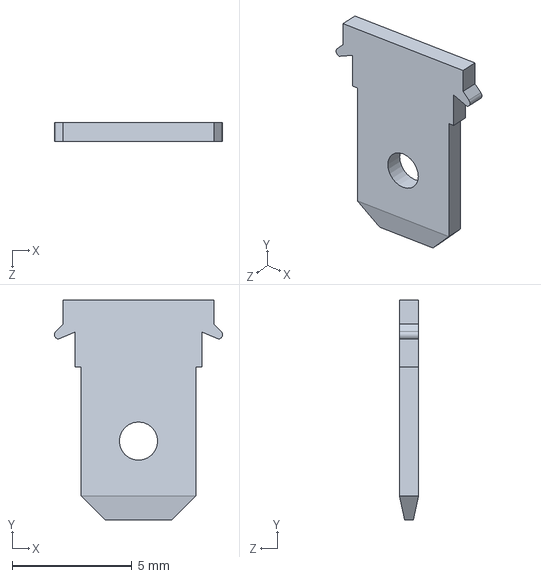
[picture p43: CAD file, 2016-12-14]
cad/solidworks_2016_org/RR5-4.8 TAB Small Hole.sldprt
7.03 x 9.20 x 0.8 mm
