fjliving/SmartSleeve/cad/solidworks_2016_org/pcb.SLDPRT

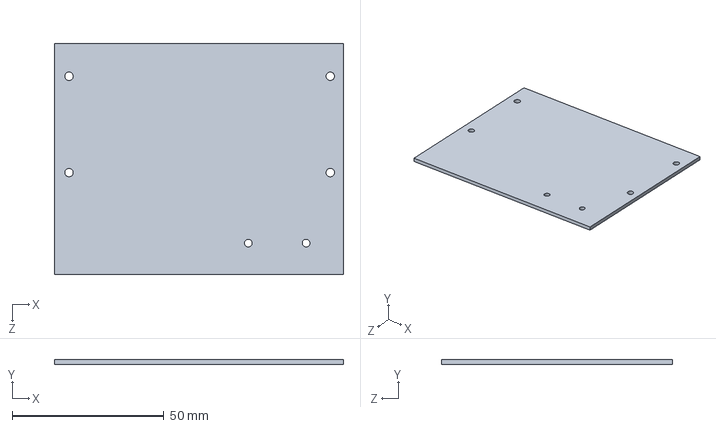
[picture p44: CAD file, 2016-12-14]
cad/solidworks_2016_org/pcb.SLDPRT
95.2 x 1.60 x 76.2 mm
