fjliving/SmartSleeve/cad/6941A001 Smart Reader 2016-12-15/6941 AE Access Panel.SLDPRT

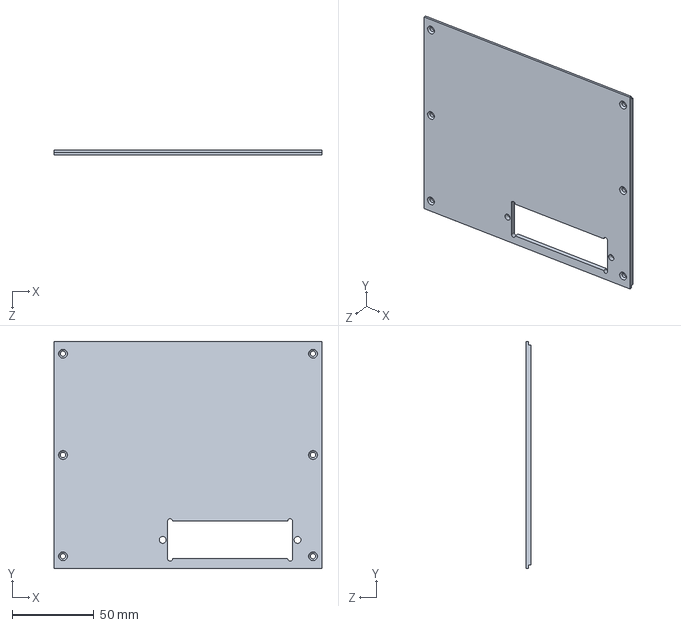
[picture p45: CAD file, 2017-01-10]
cad/6941A001 Smart Reader 2016-12-15/6941 AE Access Panel.SLDPRT
164.1 x 139.0 x 3.00 mm
