fjliving/SmartSleeve/cad/solidworks_2016_org/MUSB-AA11-35.sldprt

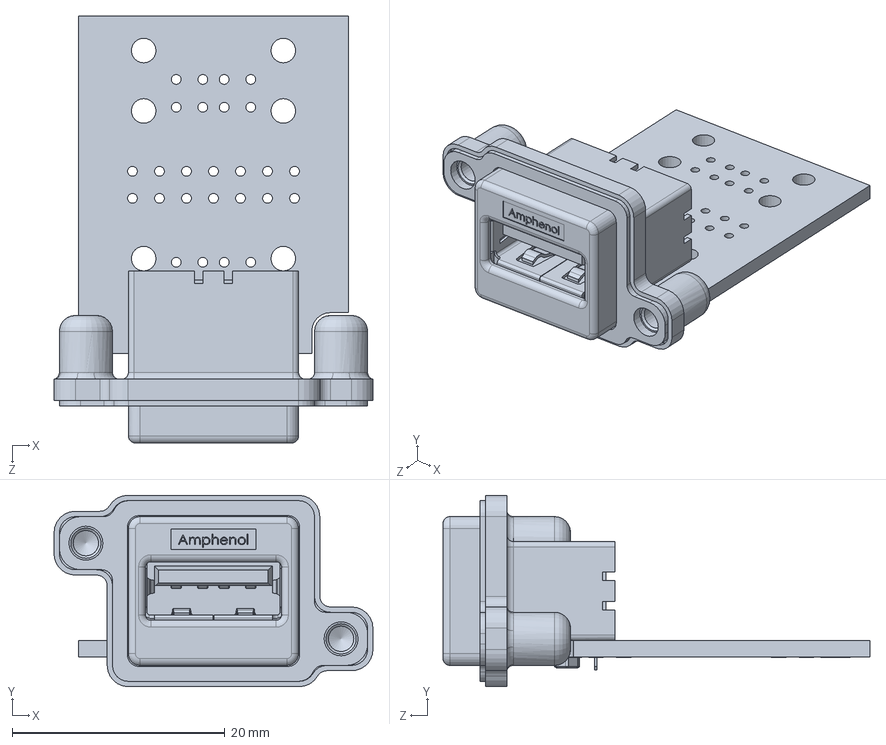
[picture p46: CAD file, 2016-12-14]
cad/solidworks_2016_org/MUSB-AA11-35.sldprt
30.0 x 18.0 x 40.2 mm
