fjliving/SmartSleeve/cad/solidworks_2016_org/277-11614-1-ND.SLDPRT

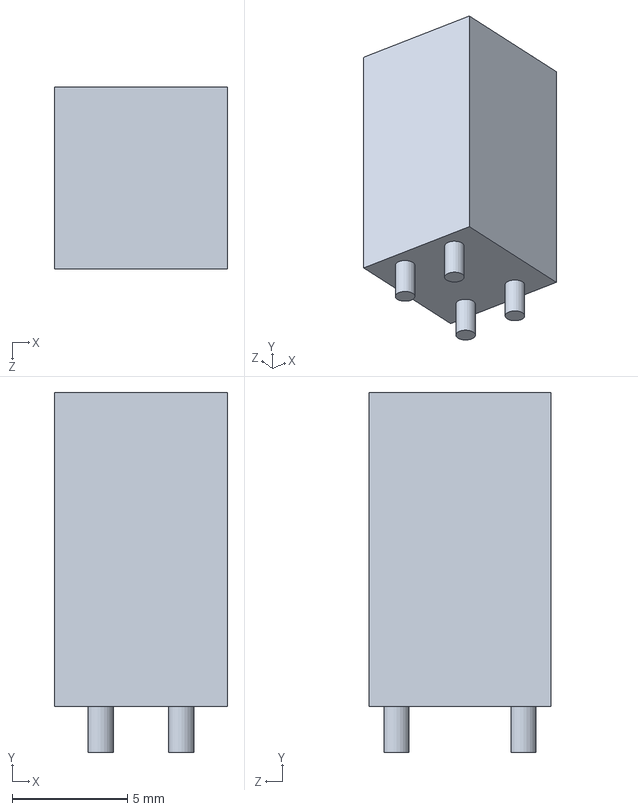
[picture p47: CAD file, 2016-12-14]
cad/solidworks_2016_org/277-11614-1-ND.SLDPRT
7.50 x 15.6 x 7.90 mm
