fjliving/SmartSleeve/(list of files, cad)

Other CAD files:
cad/solidworks_2016_org/MUSB-2A111-0X4-ASSY.sldprt
cad/6941A001 Smart Reader 2016-12-15/MUSBAA11M0.sldprt
cad/6941A001 Smart Reader 2016-12-15/lcd_pcb_org.sldprt
cad/solidworks_2016_org/bx0027.SLDPRT
cad/6941A001 Smart Reader 2016-12-15/277-11614-1-ND.sldprt
cad/6941A001 Smart Reader 2016-12-15/pcb.sldprt
cad/6941A001 Smart Reader 2016-12-15/RR5-ROCKER I-O.sldprt
cad/6941A001 Smart Reader 2016-12-15/6941 AC End Cap_ORG.SLDPRT
cad/solidworks_2016_org/MUSB-2A111-0X4 STRAIGHT.sldprt
cad/6941A001 Smart Reader 2016-12-15/6941 AC End Cap.SLDPRT
cad/6941A001 Smart Reader 2016-12-15/RR5-4.8 TAB Small Hole.sldprt
cad/6941A001 Smart Reader 2016-12-15/129-0701-202.sldprt
cad/solidworks_2016_org/RR5 BODY.sldprt
cad/6941A001 Smart Reader 2016-12-15/pcb_test.sldprt
cad/6941A001 Smart Reader 2016-12-15/90295A040_NYLON FLAT WASHER.sldprt
cad/6941A001 Smart Reader 2016-12-15/951140-8622-AR.sldprt
cad/6941A001 Smart Reader 2016-12-15/INS440135.SLDPRT
cad/encaps/6941 AB End Cap.DWG
cad/solidworks_2016_org/90272A077_ZINC-PLTD STL PAN HEAD PHILLIPS MACHINE SCREW.SLDPRT
cad/solidworks_2016_org/90272A108_ZINC-PLTD STL PAN HEAD PHILLIPS MACHINE SCREW.SLDPRT
cad/solidworks_2016_org/90295A040_NYLON FLAT WASHER.SLDPRT
cad/solidworks_2016_org/92394A111_18-8SS PRESS-FIT EXPANSION INSERT FOR PLASTIC.SLDPRT
cad/solidworks_2016_org/951140-8622-AR.SLDPRT
cad/solidworks_2016_org/INS440135.SLDPRT
cad/solidworks_2016_org/case_back_flange.SLDDRW
cad/solidworks_2016_org/case_front_flange.SLDDRW
cad/solidworks_2016_org/case_stand.SLDDRW
schematic/Allegro Footprionts/129-0701-202/129-0701-202.psm
schematic/Allegro Footprionts/CAPC2013X140N/CAPC2013X140N_Allegro/capc2013x140n.psm
schematic/Allegro Footprionts/CAPCP2013X140N/CAPCP2013X140N_Allegro/capcp2013x140n.psm
schematic/Allegro Footprionts/CRYSTAL1190X300N/CRYSTAL1190X300N_Allegro/crystal1190x300n.psm
schematic/Allegro Footprionts/DIOC2512X140N/DIOC2512X140N_Allegro/dioc2512x140n.psm
schematic/Allegro Footprionts/DIP254P254X533-6N/DIP254P254X533-6N_Allegro/dip254p254x533-6n.psm
schematic/Allegro Footprionts/DIP254P254X533-6N/DIP254P254X533-6N_Allegro/dip254p254x533-6nm.psm
schematic/Allegro Footprionts/DIP500P550X533-4N/DIP500P550X533-4N_Allegro/dip500p550x533-4n.psm
schematic/Allegro Footprionts/HOLE125/hole125.psm
schematic/Allegro Footprionts/QFP80P1200X1200X120-45N/QFP80P1200X1200X120-45N_Allegro/qfp80p1200x1200x120-45n.psm
schematic/Allegro Footprionts/RESC2013X140N/RESC2013X140N_Allegro/resc2013x140n.psm
schematic/Allegro Footprionts/SOP50P440X140-10N/SOP50P440X140-10N_Allegro/sop50p440x140-10n.psm
schematic/Allegro Footprionts/SOT95P280X112-6N/SOT95P280X112-6N_Allegro/sot95p280x112-6n.psm
schematic/Allegro Footprionts/ST7565/st7565.psm
schematic/Allegro Footprionts/TO254P1394X457-4N/TO254P1394X457-4N_Allegro/to254p1394x457-4n.psm
