fjliving/SmartSleeve/schematic/SmartSleeveSch.pdf

0
0

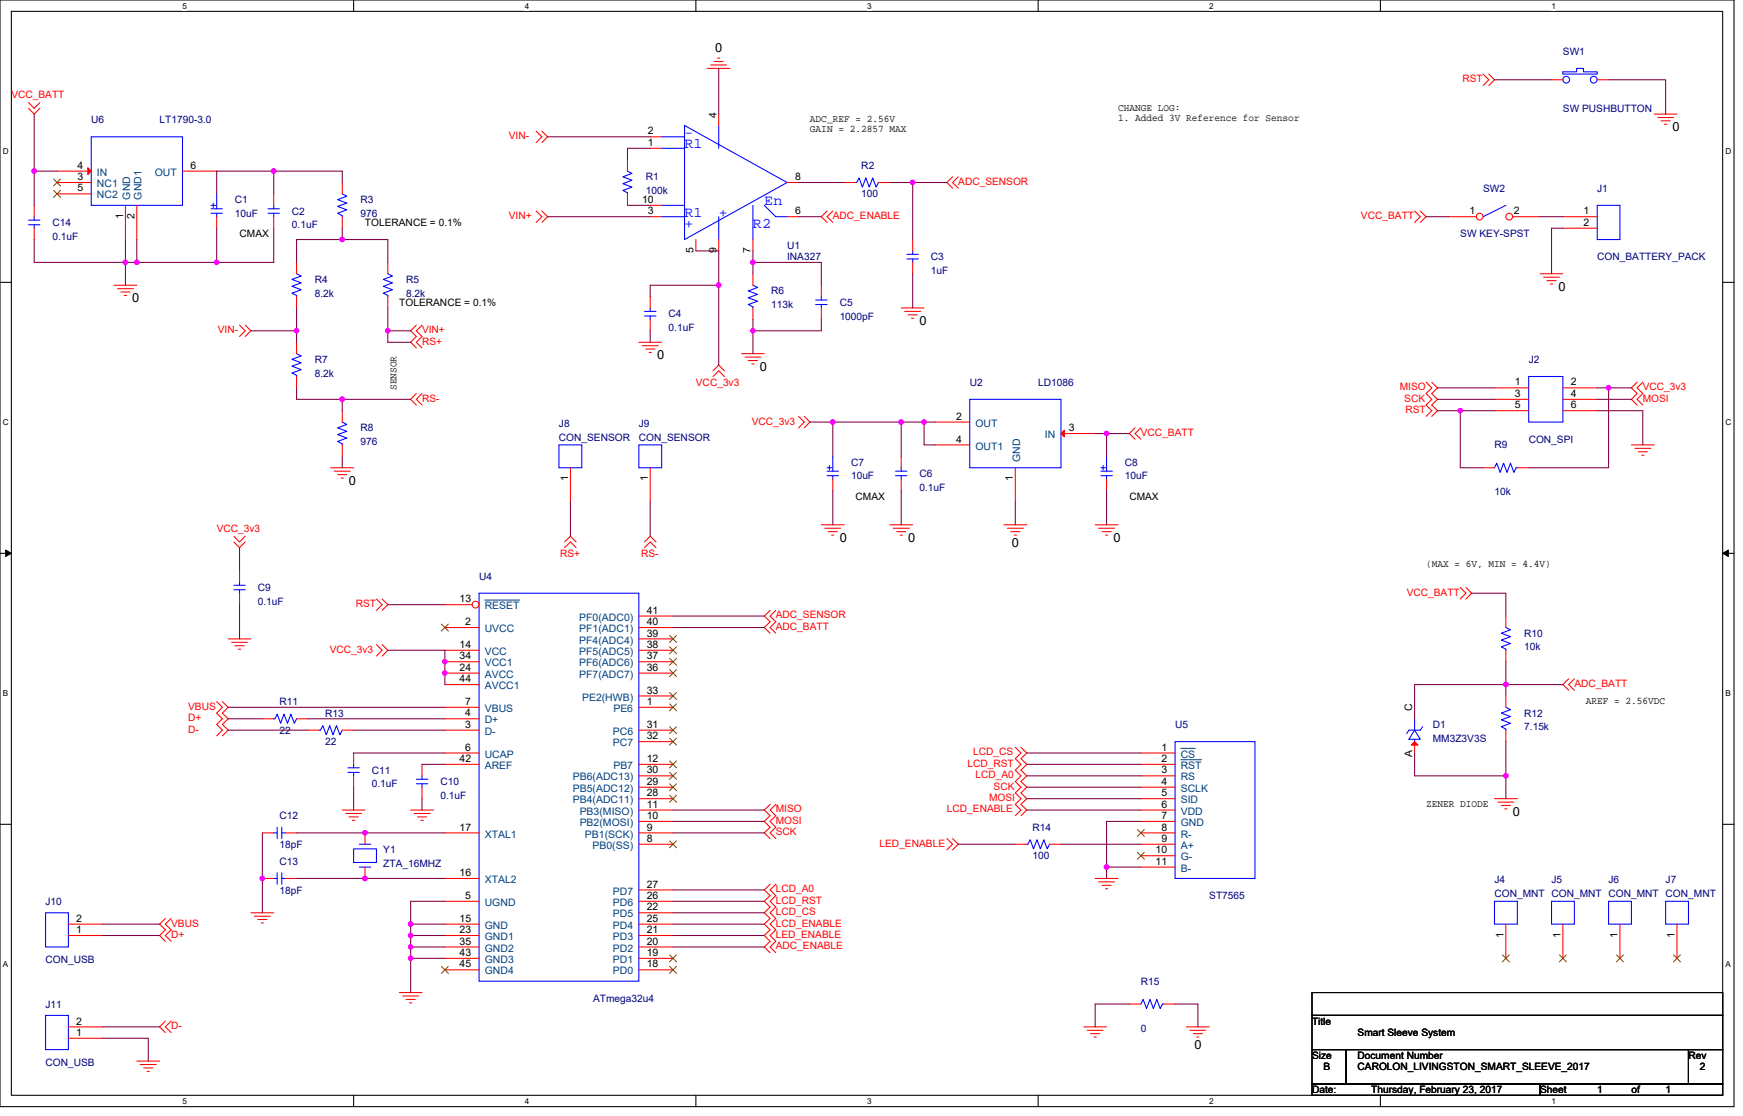
[picture p48: page 1]

CHANGE LOG:
1. Added 3V Reference for Sensor

Size Size Size B B B | Document Number Document Number Document Number CAROLON_LIVINGSTON_SMART_SLEEVE_2017 CAROLON_LIVINGSTON_SMART_SLEEVE_2017 CAROLON_LIVINGSTON_SMART_SLEEVE_2017 | Rev Rev Rev 2 2 2

Date: Date: Date: Thursday, February 23, 2017 Thursday, February 23, 2017 Thursday, February 23, 2017 | Sheet Sheet Sheet 1 1 1 of of of 1 1 1
