fjliving/SmartSleeve/cad/6941A002 Smart Reader/6941A002 Smart Reader 2017-01-16.PDF

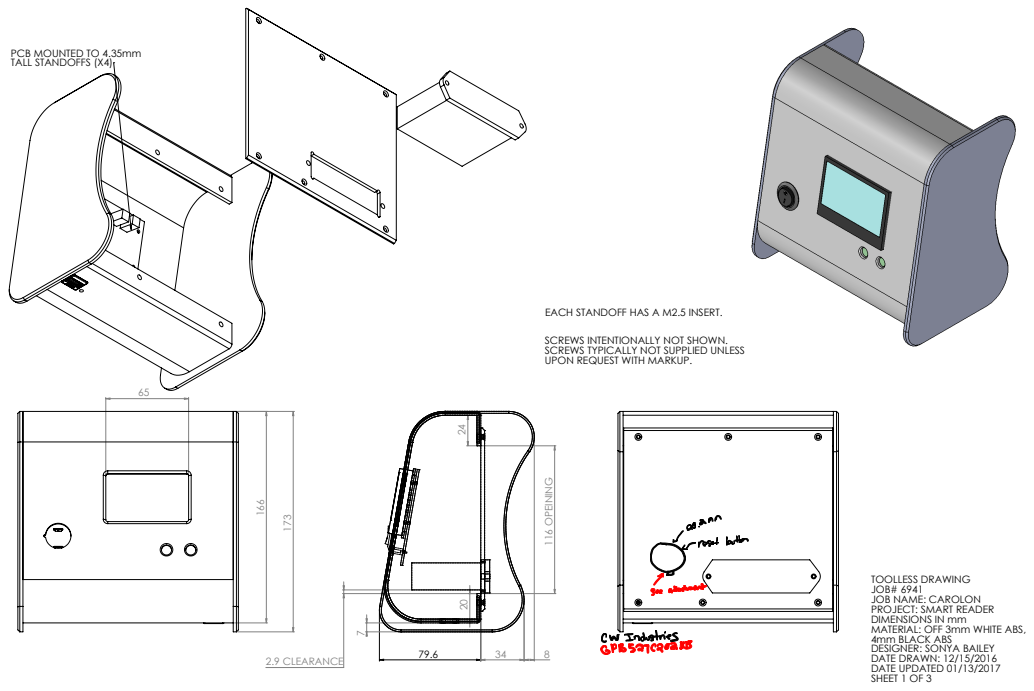
[picture p49: page 1]
116 OPEINING; 2.9 CLEARANCE

PCB MOUNTED TO 4.35mm
TALL STANDOFFS (X4)

EACH STANDOFF HAS A M2.5 INSERT.

SCREWS INTENTIONALLY NOT SHOWN.
SCREWS TYPICALLY NOT SUPPLIED UNLESS
UPON REQUEST WITH MARKUP.

TOOLLESS DRAWING
JOB# 6941
JOB NAME: CAROLON
PROJECT: SMART READER
DIMENSIONS IN mm
MATERIAL: OFF 3mm WHITE ABS,
4mm BLACK ABS
DESIGNER: SONYA BAILEY
DATE DRAWN: 12/15/2016
DATE UPDATED 01/13/2017
SHEET 1 OF 3

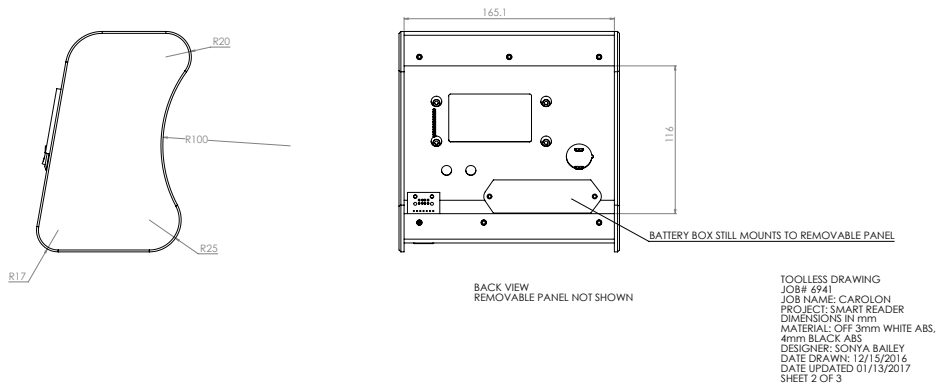
[picture p50: page 2]

BATTERY BOX STILL MOUNTS TO REMOVABLE PANEL

TOOLLESS DRAWING
JOB# 6941
JOB NAME: CAROLON
PROJECT: SMART READER
DIMENSIONS IN mm
MATERIAL: OFF 3mm WHITE ABS,
4mm BLACK ABS
DESIGNER: SONYA BAILEY
DATE UPDATED 01/13/2017

BACK VIEW
REMOVABLE PANEL NOT SHOWN

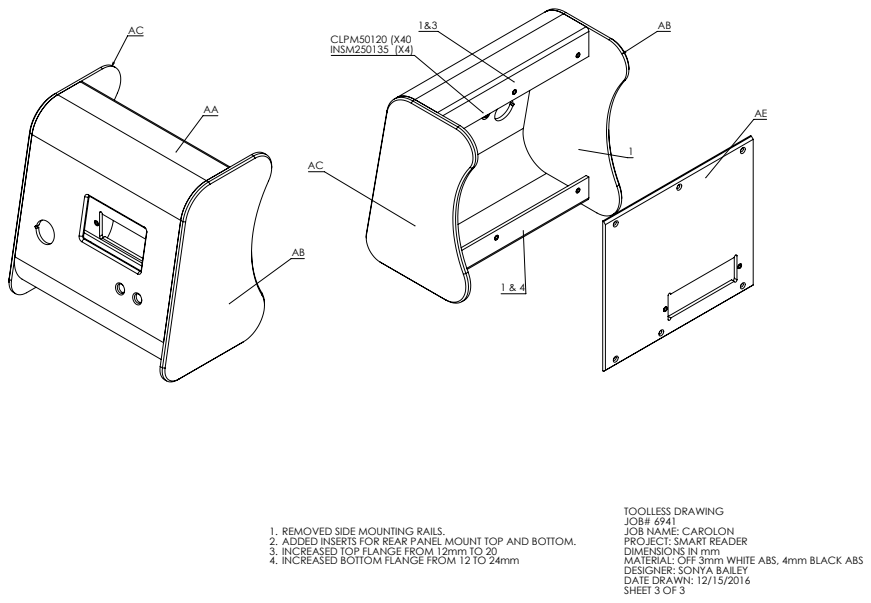
[picture p51: page 3]
CLPM50120 (X40 INSM250135 (X4)

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

1. REMOVED SIDE MOUNTING RAILS.
2. ADDED INSERTS FOR REAR PANEL MOUNT TOP AND BOTTOM.
3. INCREASED TOP FLANGE FROM 12mm TO 20
4. INCREASED BOTTOM FLANGE FROM 12 TO 24mm
