fjliving/SmartSleeve/schematic/allegro/SMARTSLEEVESYSTEM.pdf

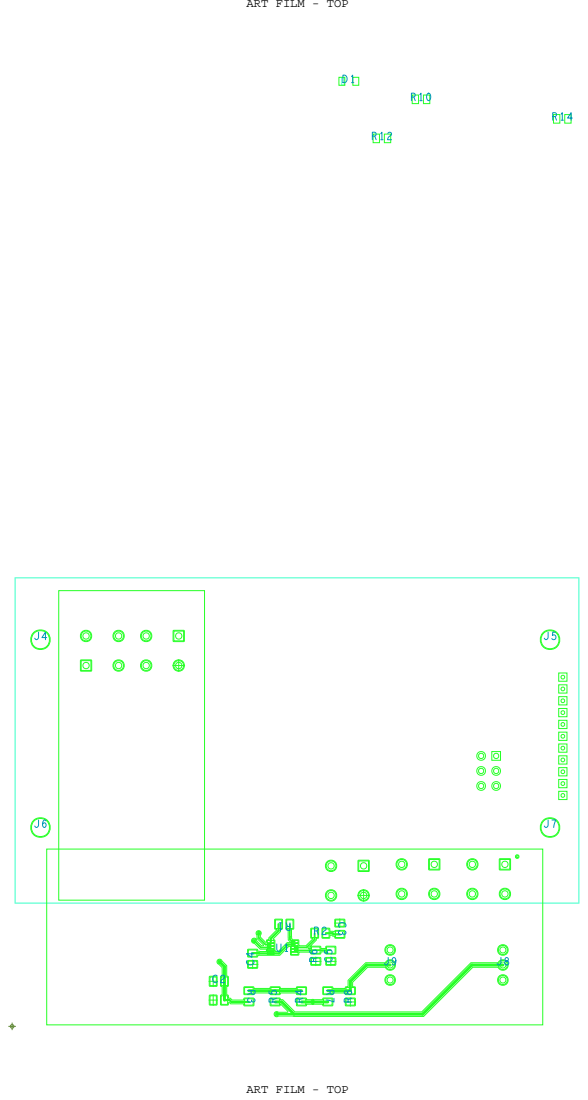
[picture p52: page 1]

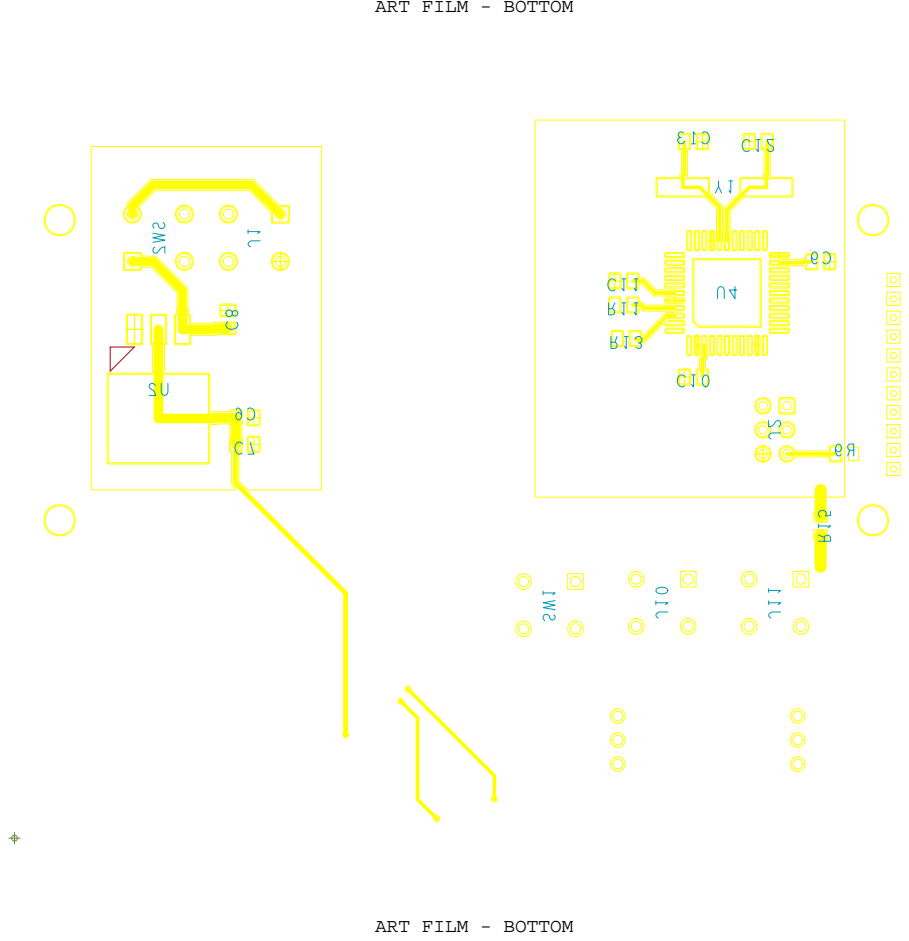
[picture p53: page 2]
