fjliving/SmartSleeve/(list of files, drawings)

Other design files:
schematic/simulation.dsn
schematic/simulation.opj
schematic/SMARTSLEEVESYSTEM.DSN
schematic/SmartSleeveSystem.opj
