fjliving/SmartSleeve/(commit log)

2016-12-14 uploaded cad model
    [129-0701-202.SLDPRT, 277-11614-1-ND.SLDPRT, 90272A077_ZINC-PLTD STL PAN HEAD PHILLIPS MACHINE SCREW.SLDPRT, 90272A108_ZINC-PLTD STL PAN HEAD PHILLIPS MACHINE SCREW.SLDPRT, 90295A040_NYLON FLAT WASHER.SLDPRT, 92394A111_18-8SS PRESS-FIT EXPANSION INSERT FOR PLASTIC.SLDPRT, 951140-8622-AR.SLDPRT, M-MUSB-AA11-XX-REVG1.SLDASM]
2016-12-14 uploaded manufacutring files
    [case_back_flange.SLDPRT, case_front_flange.SLDPRT, case_stand.SLDPRT, smartreader_v3 - 90272A077_ZINC-PLTD STL PAN HEAD PHILLIPS MACHINE SCREW-1.STL, smartreader_v3 - 90272A077_ZINC-PLTD STL PAN HEAD PHILLIPS MACHINE SCREW-10.STL, smartreader_v3 - 90272A077_ZINC-PLTD STL PAN HEAD PHILLIPS MACHINE SCREW-11.STL, smartreader_v3 - 90272A077_ZINC-PLTD STL PAN HEAD PHILLIPS MACHINE SCREW-12.STL, smartr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]
2016-12-14 organize dir
    [129-0701-202.SLDPRT, 277-11614-1-ND.SLDPRT, 90272A077_ZINC-PLTD STL PAN HEAD PHILLIPS MACHINE SCREW.SLDPRT, 90272A108_ZINC-PLTD STL PAN HEAD PHILLIPS MACHINE SCREW.SLDPRT, 90295A040_NYLON FLAT WASHER.SLDPRT, 92394A111_18-8SS PRESS-FIT EXPANSION INSERT FOR PLASTIC.SLDPRT, 951140-8622-AR.SLDPRT, M-MUSB-AA11-XX-REVG1.SLDASM]
2017-01-10 uploaded prototype files
    uploaded prototype files
    [129-0701-202.SLDPRT, 129-0701-202.sldprt, 277-11614-1-ND.SLDPRT, 277-11614-1-ND.sldprt, 6941 500 Smart Reader.SLDASM, 6941 AA Wrap.SLDPRT, 6941 AB End Cap.DWG, 6941 AB End Cap.DXF]
2017-01-10 moved laser cut files
    moved lase cut files
    [6941 AB End Cap.DWG, 6941 AB End Cap.DXF]
2017-01-30 January Edit
    January Edit
    [6941 500 Smart Reader.SLDASM, 6941 AB End Cap.SLDPRT, CLPM50H120.SLDPRT, PCB smartreader_v3.SLDASM, SMARTSLEEVESYSTEM.DSN, SmartSleeveBOM.xlsx, SmartSleeveSystem.opj, lcd_pcb.SLDPRT]
2017-01-31 updated schematic
    updated schematic
    [129-0701-202.psm, SMARTSLEEVESYSTEM.DSN, SMARTSLEEVESYSTEM.brd, SmartSleeveBOM.xlsx, SmartSleeveSystem.opj, capc2013x140n.psm, capcp2013x140n.psm, cases.cfg]
2017-02-02 updated gerber
    updated gerber
    [SMARTSLEEVESYSTEM.brd, SmartSleeveSystem.opj, art_param.txt, nc_param.txt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]
2017-02-03 updater Gerber
    updated Gerber
    [SMARTSLEEVESYSTEM.brd, SmartSleeveSystem.opj, art_param.txt, sop50p440x140-10n.psm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]
2017-02-06 7 mils clearance update
    7 mils clearance update
    [SMARTSLEEVESYSTEM.brd, art_param.txt]
2017-02-15 Implemeted Firmware in AVR Studio
    Implemeted Firmware in AVR Studio
    [SMARTSLEEVESYSTEM.DSN, SmartSleeveSystem.opj, simulation.dsn, simulation.opj]
2017-03-05 Release Version 1.0
    Release Version 1.0
    [SMARTSLEEVESYSTEM.DSN, SMARTSLEEVESYSTEM.brd, SmartSleeveBOM.xlsx, SmartSleeveSystem.opj, nc_param.txt, simulation.dsn, simulation.opj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]
2017-03-07 removed lcd connectors
    removed lcd connectors
2017-03-07 uploaded production images
    uploaded production images
    [SmartSleeveBOM.xlsx]
